GasimovDev/guitar-pedal/hardware/fab/enclosure-drill-template.pdf

## PEDAL FACE (top of the box) - drilling template, seen from OUTSIDE

Print at 100 % ('actual size', no 'fit to page'). Check the 50 mm bar with a ruler.
Tape it on the box, centre-punch every cross, drill small (3 mm) first, then open up with a step drill.

this bar must measure exactly 50 mm

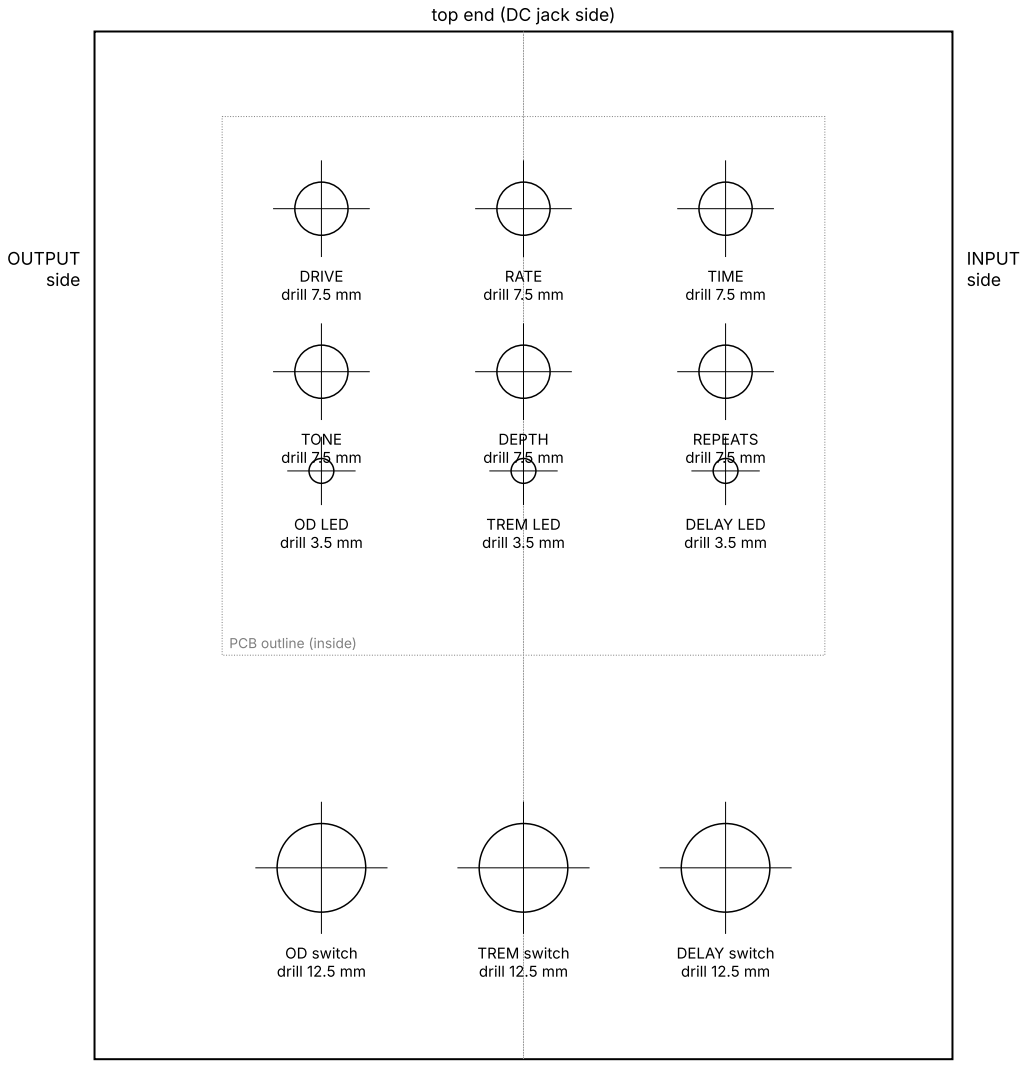
[picture p3: figure]
top end (DC jack side); OUTPUT side; INPUT side; PCB outline (inside); DRIVE drill 7.5 mm; TONE drill 7.5 mm; RATE drill 7.5 mm; DEPTH drill 7.5 mm; TIME drill 7.5 mm; REPEATS drill 7.5 mm; OD LED drill 3.5 mm; TREM LED drill 3.5 mm; DELAY LED drill 3.5 mm; OD switch drill 12.5 mm; TREM switch drill 12.5 mm; DELAY switch drill 12.5 mm

Hole centres, mm from the face's top-left corner (seen from outside):
DRIVE | x 32.0 y 25.0 (7.5)
TONE | x 32.0 y 48.0 (7.5)
RATE | x 60.5 y 25.0 (7.5)
DEPTH | x 60.5 y 48.0 (7.5)
TIME | x 89.0 y 25.0 (7.5)
REPEATS | x 89.0 y 48.0 (7.5)
OD LED | x 32.0 y 62.0 (3.5)
TREM LED | x 60.5 y 62.0 (3.5)
DELAY LED | x 89.0 y 62.0 (3.5)
OD switch | x 32.0 y 118.0 (12.5)
TREM switch x 60.5 y 118.0 (12.5) DELAY switch x 89.0 y 118.0 (12.5)

Drawn for a Hammond 1590XX (145 x 121 x 39 mm). Different box? Keep the holes' positions relative to each other (they match the PCB) and centre the group on your box.

## SIDE WALLS - seen from OUTSIDE, face edge at the top

All three holes are 24 mm down from the face. That keeps the jacks below the parts on the PCB. Solder the jack and switch wires straight into J1/J2/J3/J6 (no pin headers there), so nothing sticks down.

this bar must measure exactly 50 mm

TOP END wall (121 mm)

face (top) edge

open edge (lid)

9 V DC jack
drill 12.0 mm

The DC jack sits in the middle of the top end.

RIGHT side wall = INPUT (145 mm). Top end of the box is at the RIGHT of this drawing.

face (top) edge

open edge (lid)

INPUT jack
drill 9.5 mm

Input jack centre: 33.5 mm from the top end.

LEFT side wall = OUTPUT (145 mm). Top end of the box is at the LEFT of this drawing.

face (top) edge

open edge (lid)

OUTPUT jack
drill 9.5 mm

Output jack centre: 33.5 mm from the top end.
