GasimovDev/guitar-pedal/docs/img/pcb_bottom.png

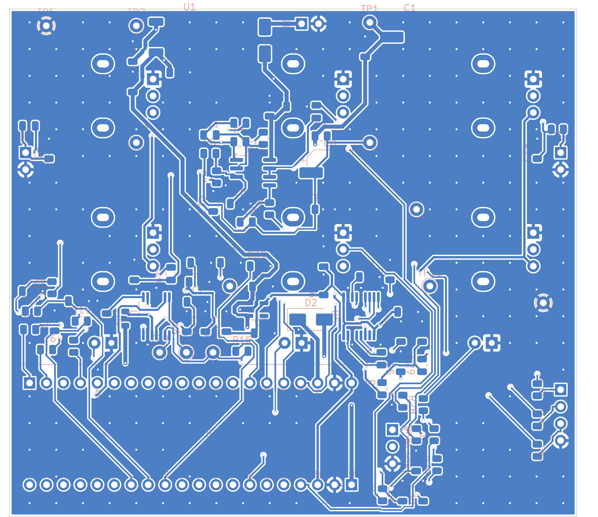
docs/img/pcb_bottom.png
