GasimovDev/guitar-pedal/docs/img/pcb_top.png

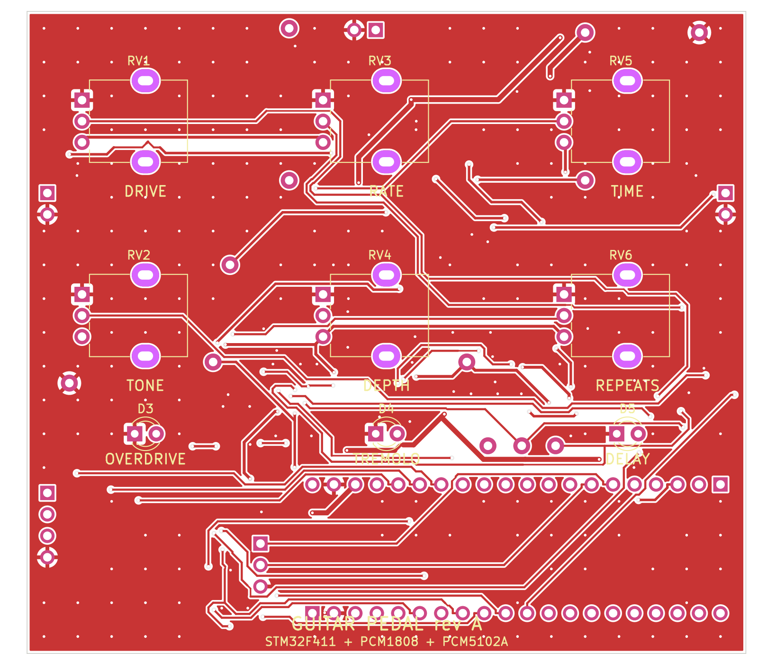
docs/img/pcb_top.png
