GasimovDev/guitar-pedal/hardware/fab/bom_jlc.csv

Comment | Designator | Footprint | LCSC Part # | Manufacturer Part | Qty
100uF 25V electrolytic | C1 | SMD electrolytic 6.3x7.7mm |  |  | 1
100nF 50V X7R/X5R | C2,C5,C9,C17,C19,C20,C25,C26,C27,C31,C33,C34,C35,C36,C37,C38,C39,C40,C41 | 0805 |  |  | 19
1uF 25V X7R/X5R | C3 | 0805 |  |  | 1
10uF 16V X7R/X5R | C4,C7,C12,C14,C16,C18,C24,C29,C30 | 0805 |  |  | 9
1uF 16V X7R/X5R | C6,C15,C23 | 0805 |  |  | 3
47uF 25V electrolytic | C8 | SMD electrolytic 6.3x5.4mm |  |  | 1
100pF 50V C0G/NP0 | C10,C11 | 0805 |  |  | 2
2.2nF 50V C0G/NP0 | C13,C28 | 0805 |  |  | 2
2.2uF 16V X7R/X5R | C21,C22 | 0805 |  |  | 2
10uF 25V X7R/X5R | C32 | 0805 |  |  | 1
SS34 | D1 | SMA (DO-214AC) |  | SS34 | 1
SS14 | D2 | SMA (DO-214AC) |  | SS14 | 1
Ferrite bead 600R@100MHz | FB1 | 0805 |  | BLM21PG601SN1D | 1
10k 1% 1/8W | R1,R2,R7,R9,R12 | 0805 |  |  | 5
1M 1% 1/8W | R3,R5 | 0805 |  |  | 2
1k 1% 1/8W | R4,R8,R14,R19,R20,R21,R22,R23,R24,R25,R26,R27 | 0805 |  |  | 12
5.1k 1% 1/8W | R6 | 0805 |  |  | 1
470 1% 1/8W | R10,R28,R29,R30 | 0805 |  |  | 4
22k 1% 1/8W | R11 | 0805 |  |  | 1
100k 1% 1/8W | R13 | 0805 |  |  | 1
33 1% 1/8W | R15,R16,R17,R18 | 0805 |  |  | 4
L78M05 | U1 | TO-252 (DPAK) |  | L78M05CDT-TR | 1
AP2112K-3.3 | U2 | SOT-23-5 |  | AP2112K-3.3TRG1 | 1
OPA1678 | U3 | SOIC-8 |  | OPA1678IDR | 1
PCM1808 | U4 | TSSOP-14 |  | PCM1808PWR | 1
PCM5102A | U5 | TSSOP-20 |  | PCM5102APWR | 1
