GasimovDev/guitar-pedal/hardware/fab/schematic.pdf

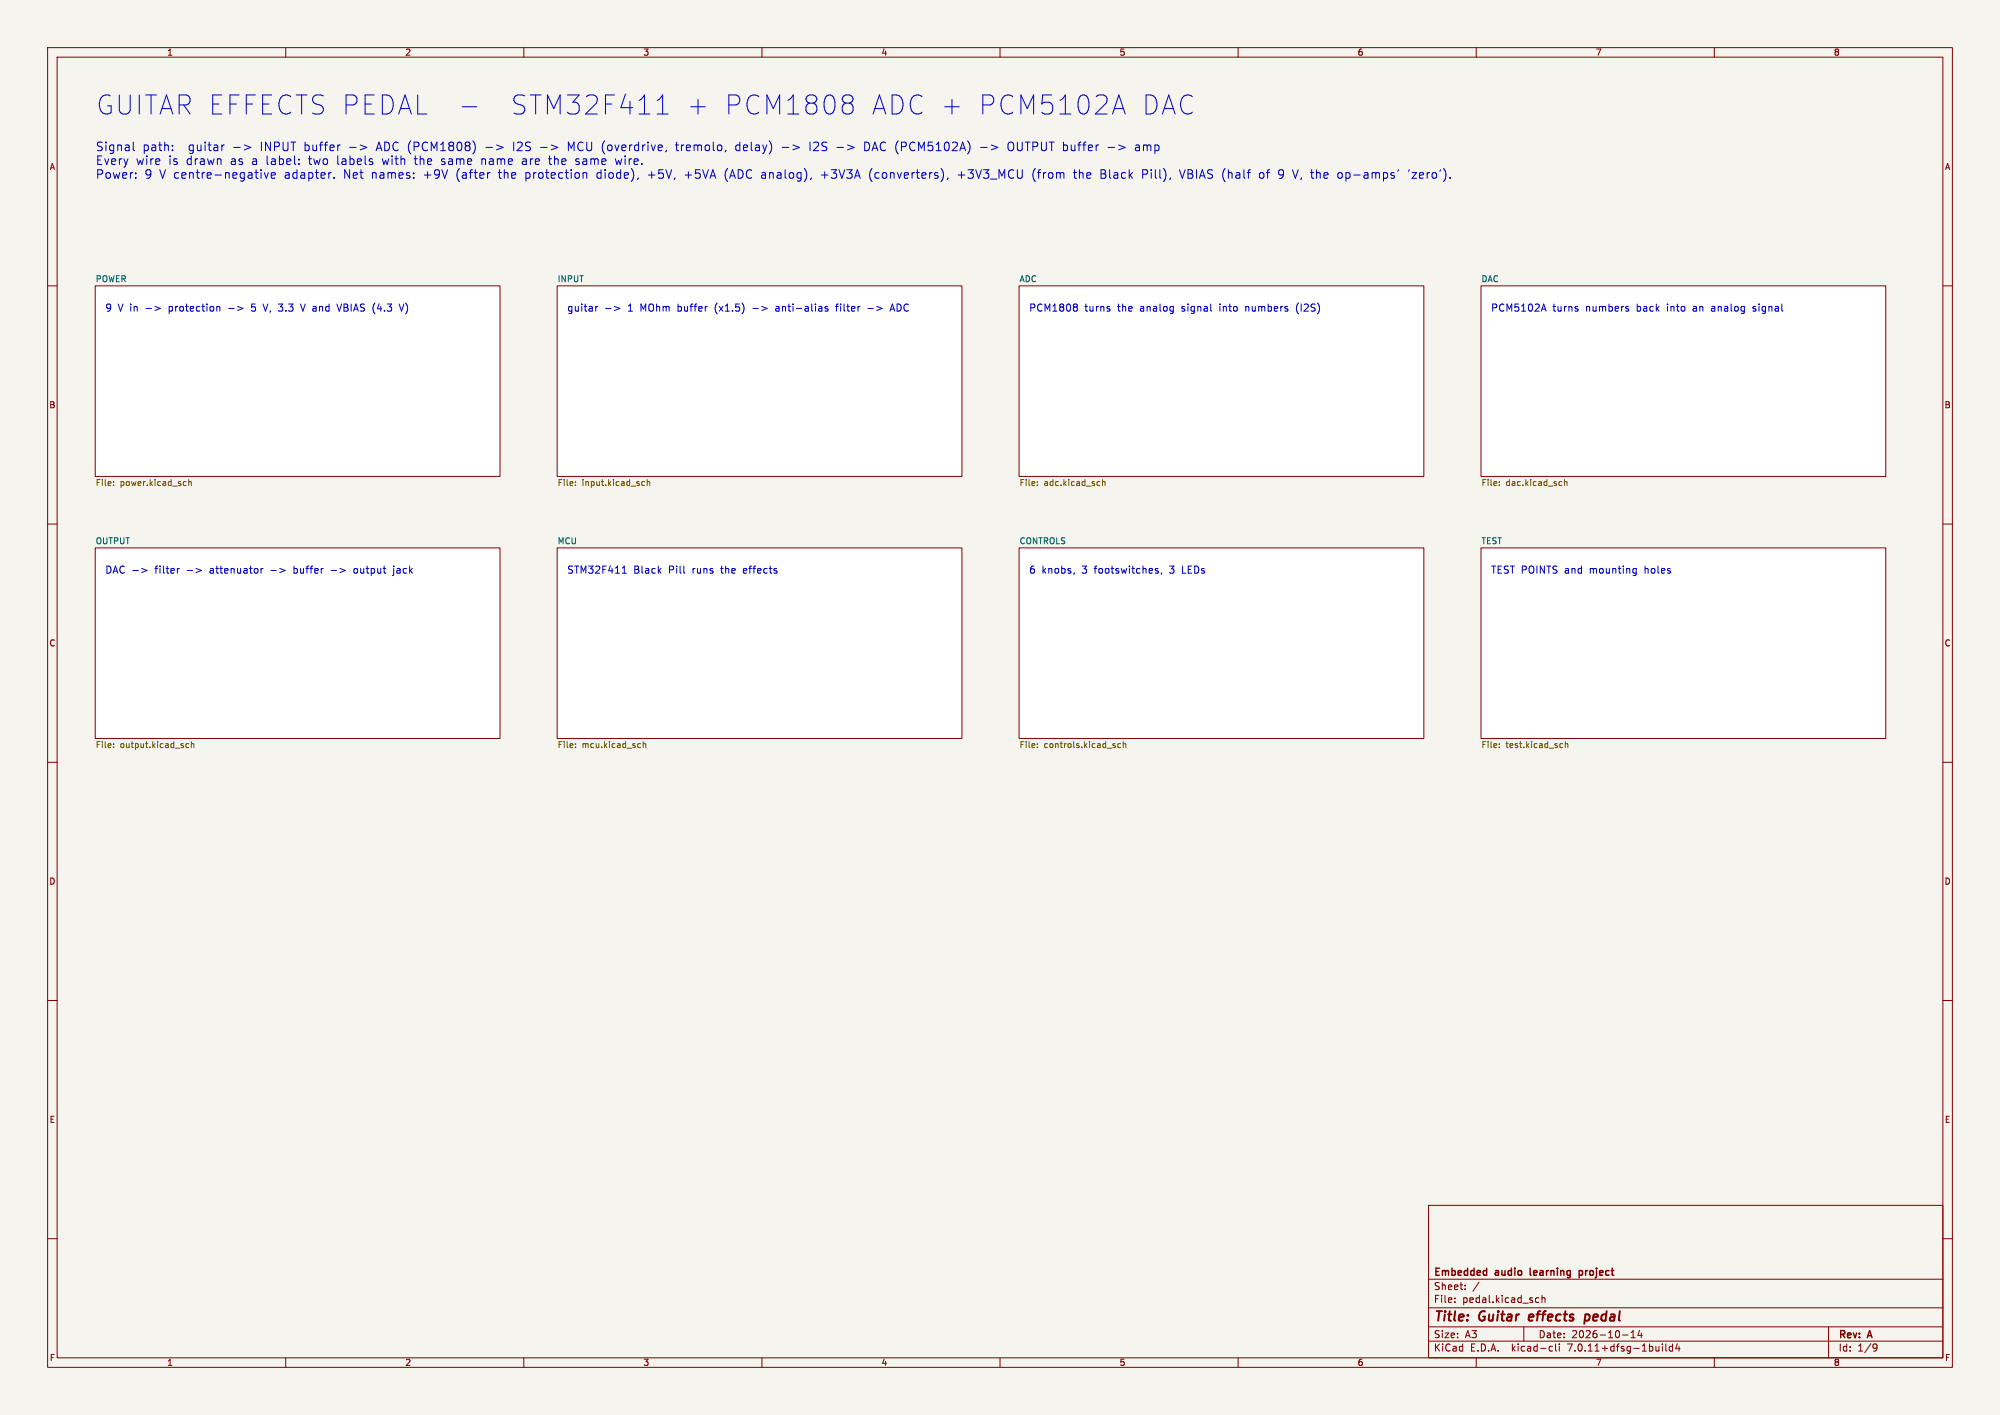
[picture p6: page 1]

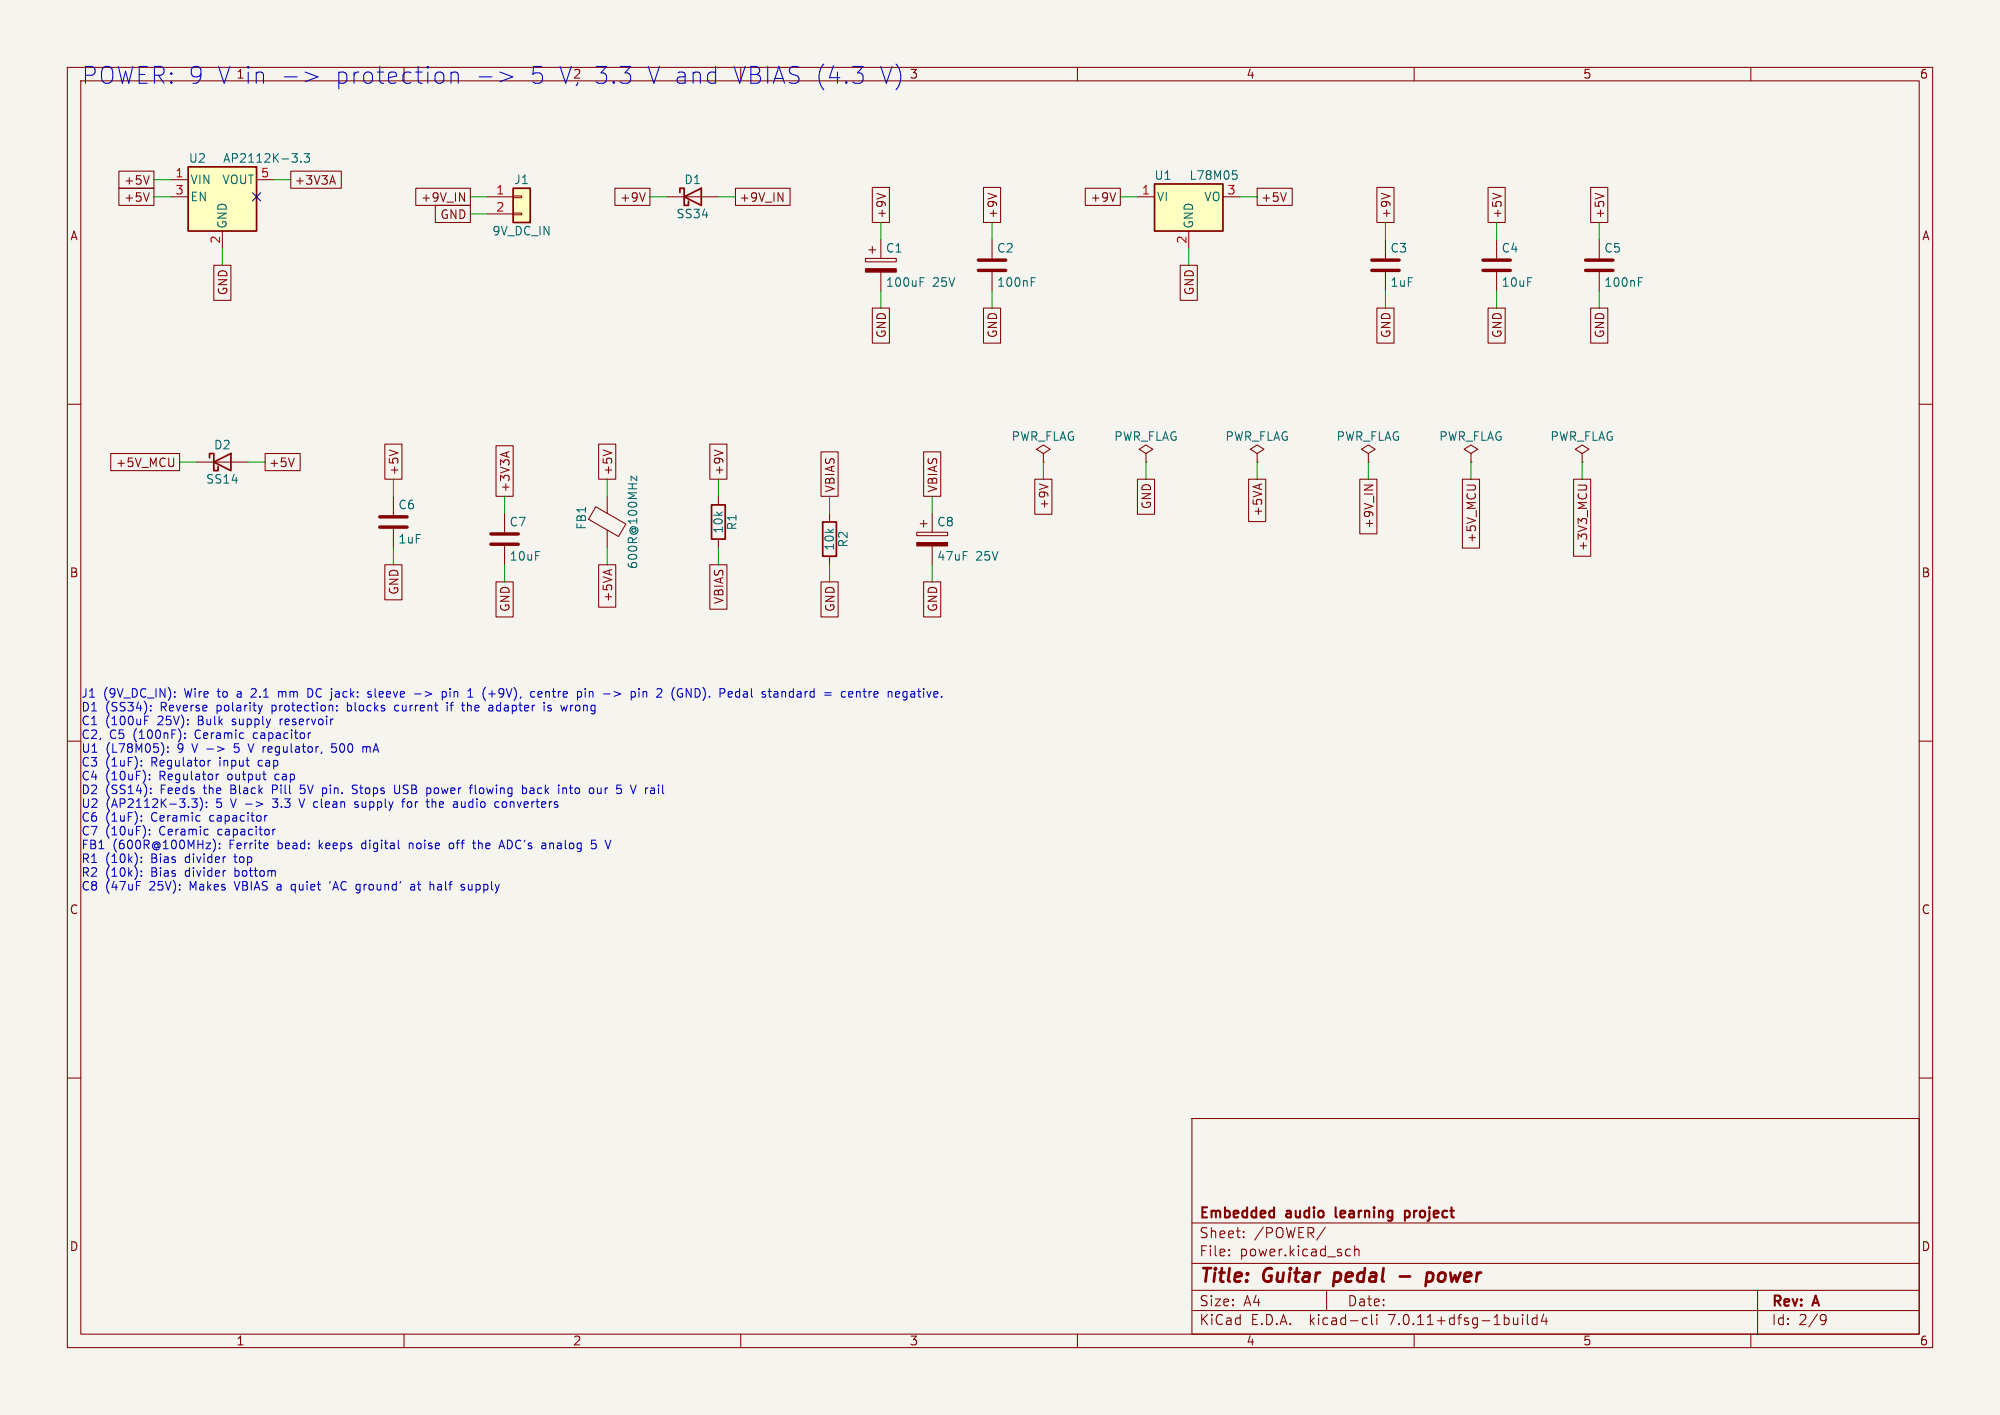
[picture p7: page 2]

C8 (47uF 25V): Makes VBIAS a quiet 'AC ground' at half supply

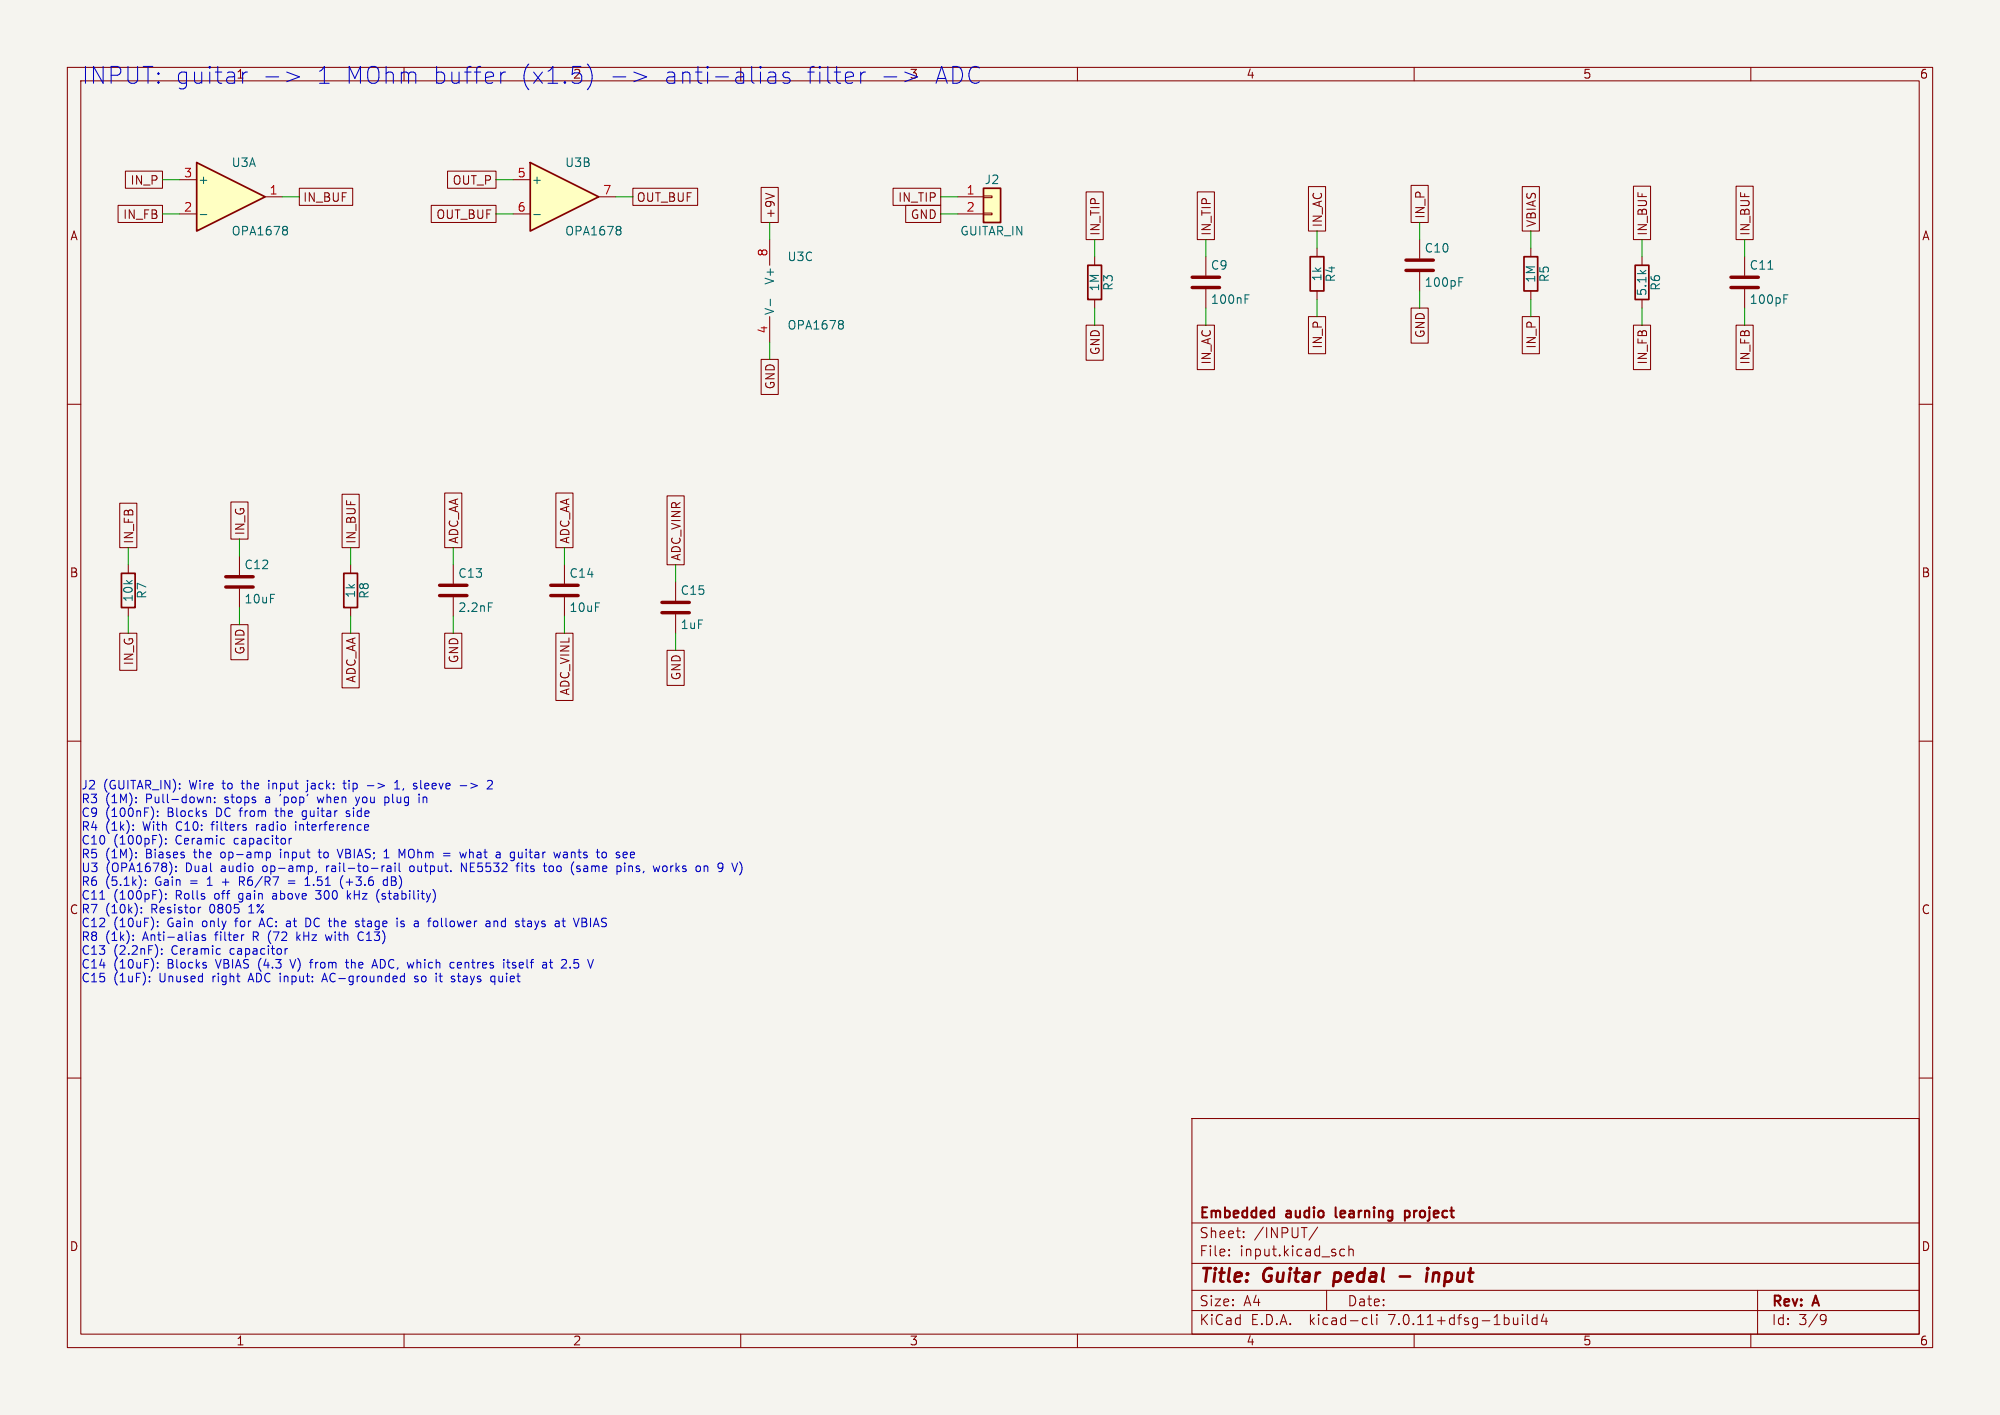
[picture p8: page 3]

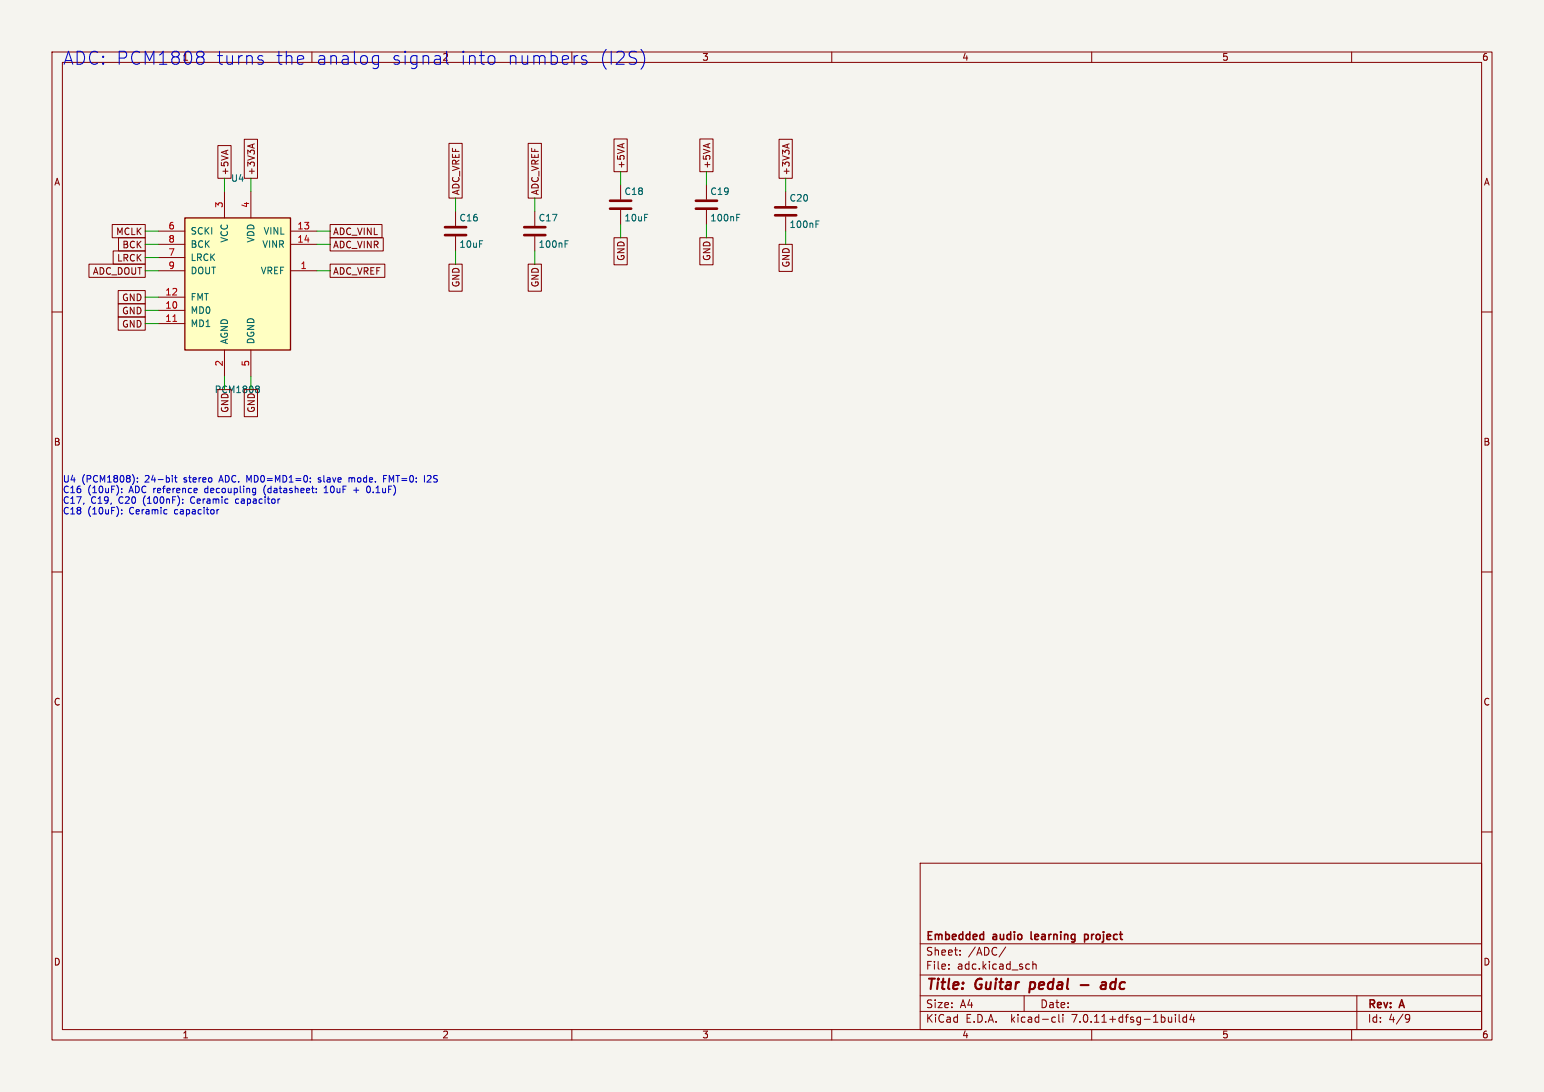
[picture p9: page 4]

Id: 4/9 Title: Guitar pedal - adc

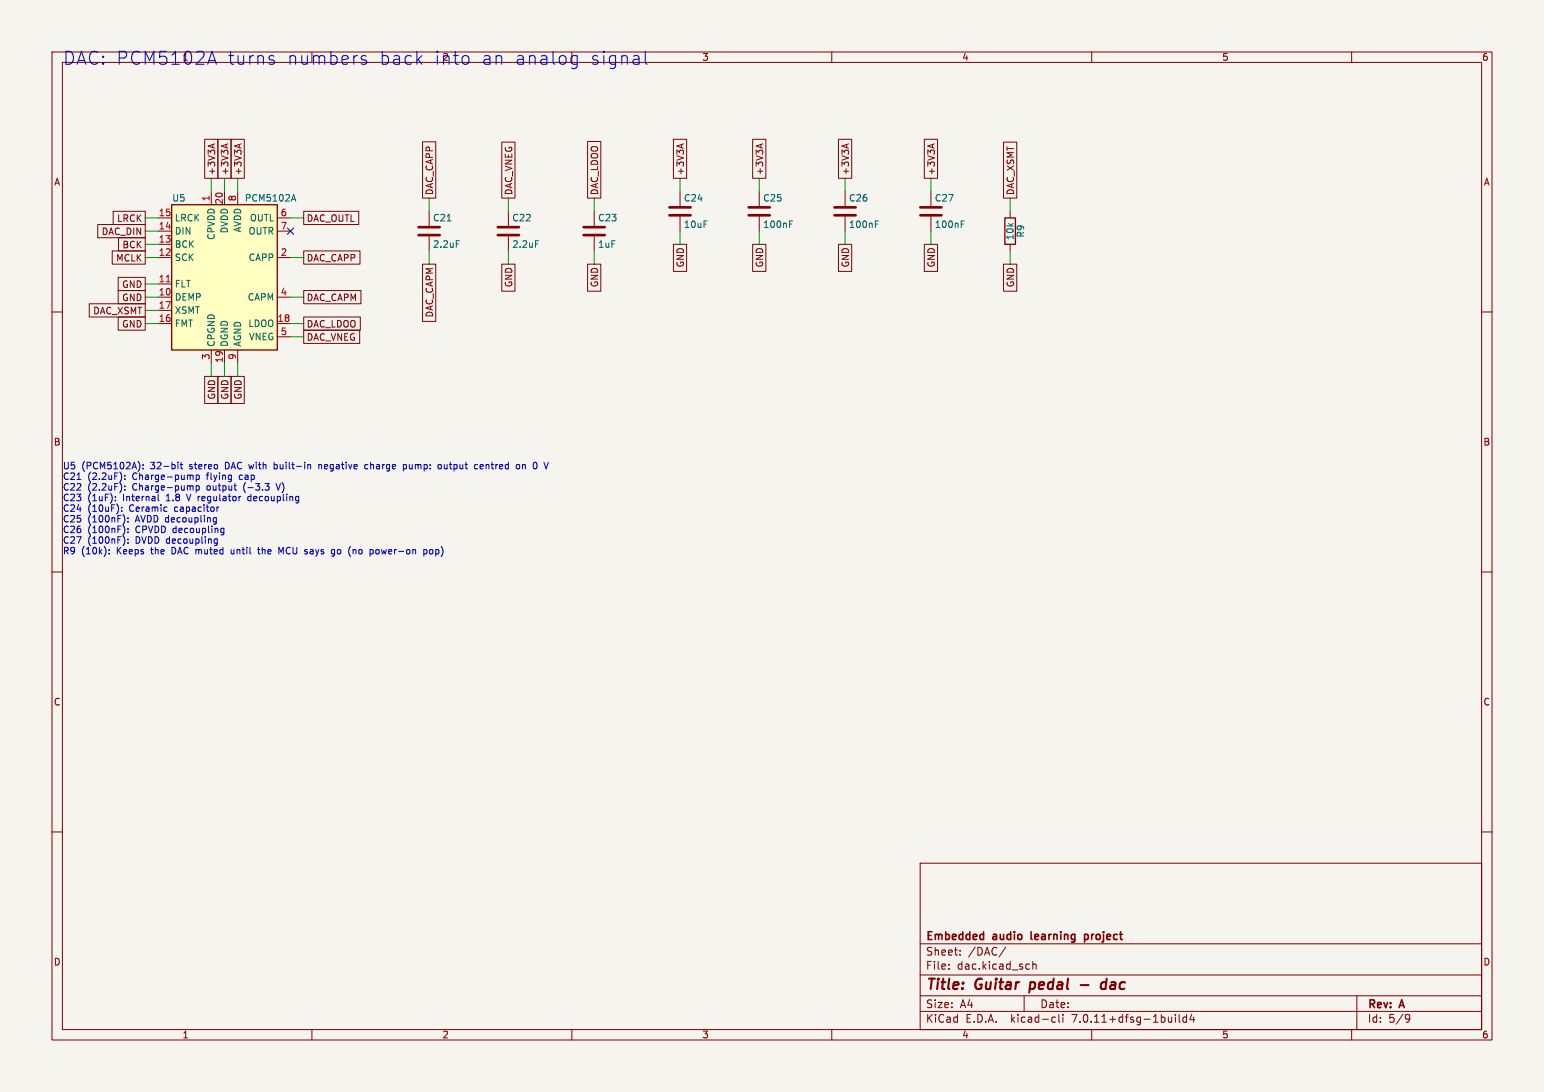
[picture p10: page 5]

LRCK GND GND MCLK

1 DEMP 10 FLT 11 SCK 12 BCK 13 DIN 14

3 CAPM 4 VNEG 5 OUTL 6 OUTR 7 AVDD

Id: 5/9 Title: Guitar pedal - dac

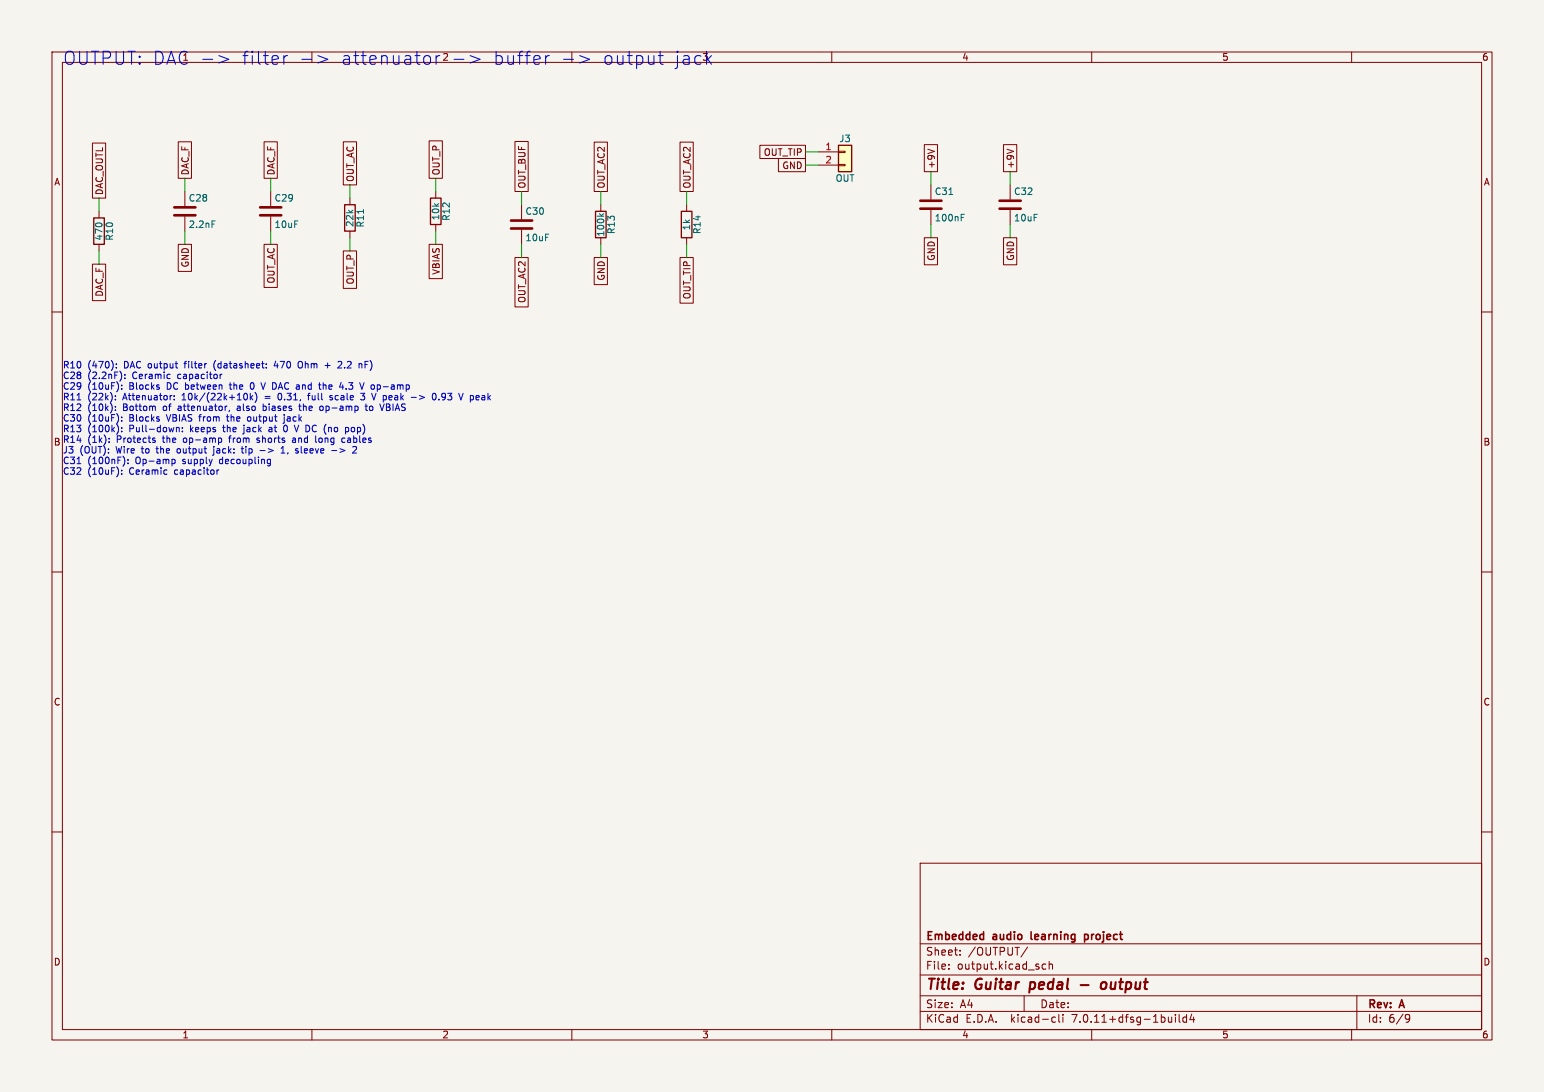
[picture p11: page 6]

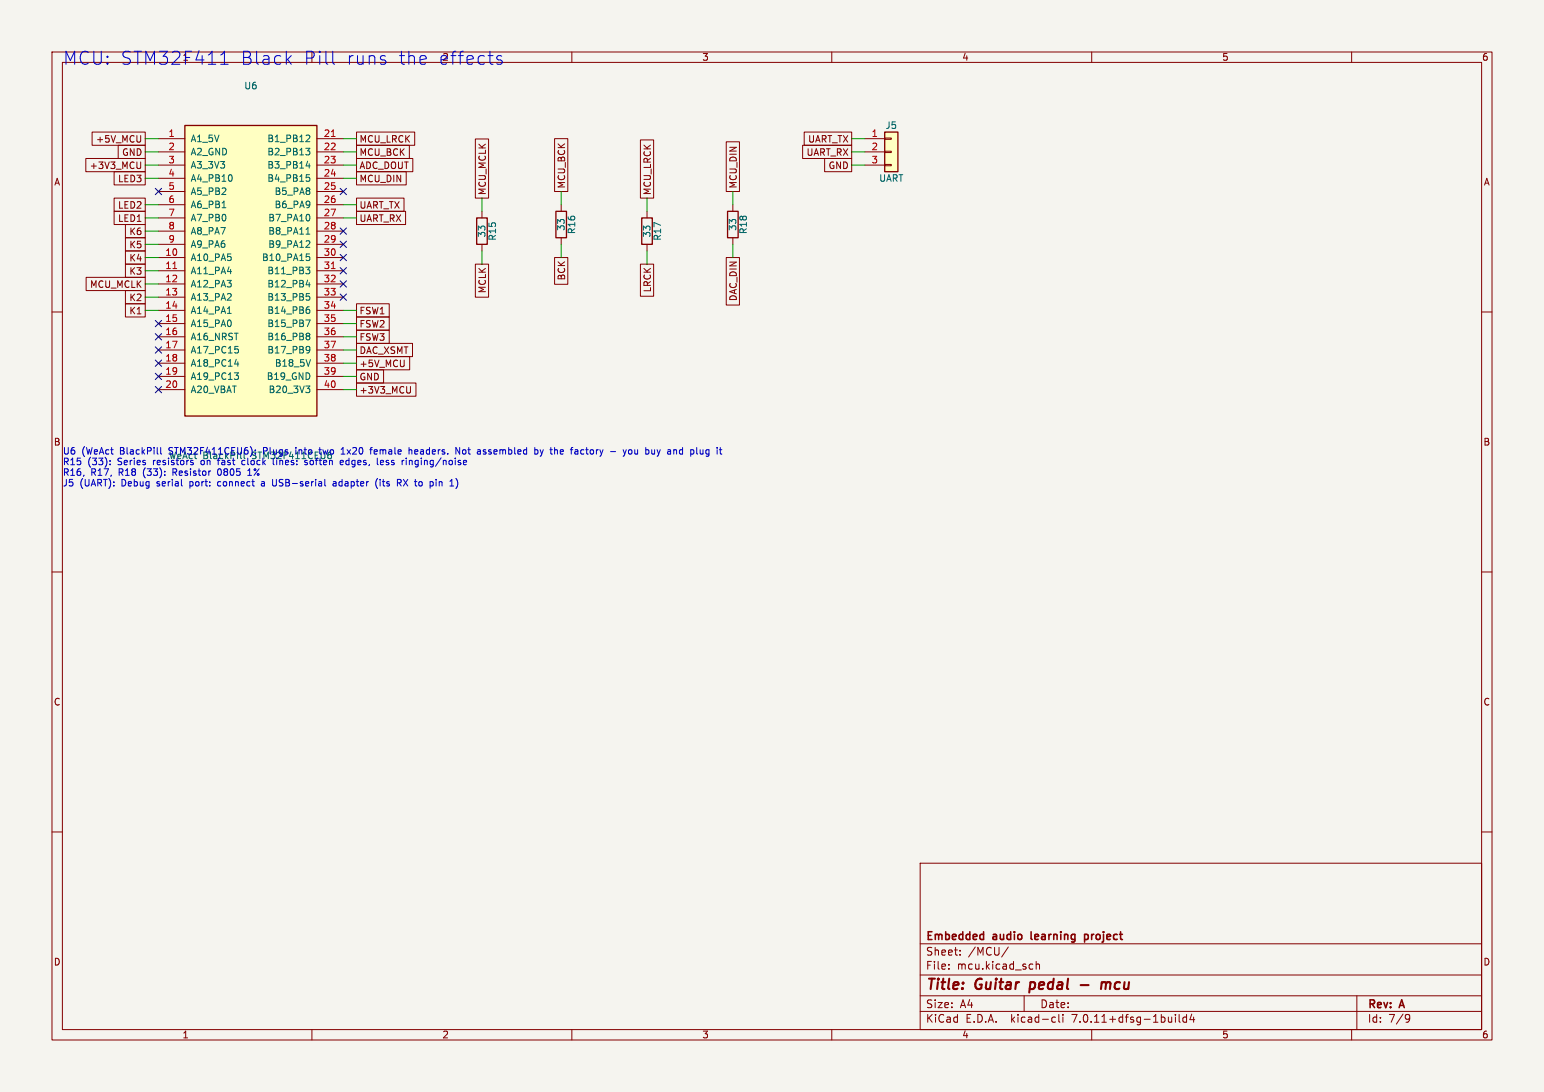
[picture p12: page 7]

MCU: STM32F411 Black Pill runs the effects

Id: 7/9 Title: Guitar pedal - mcu

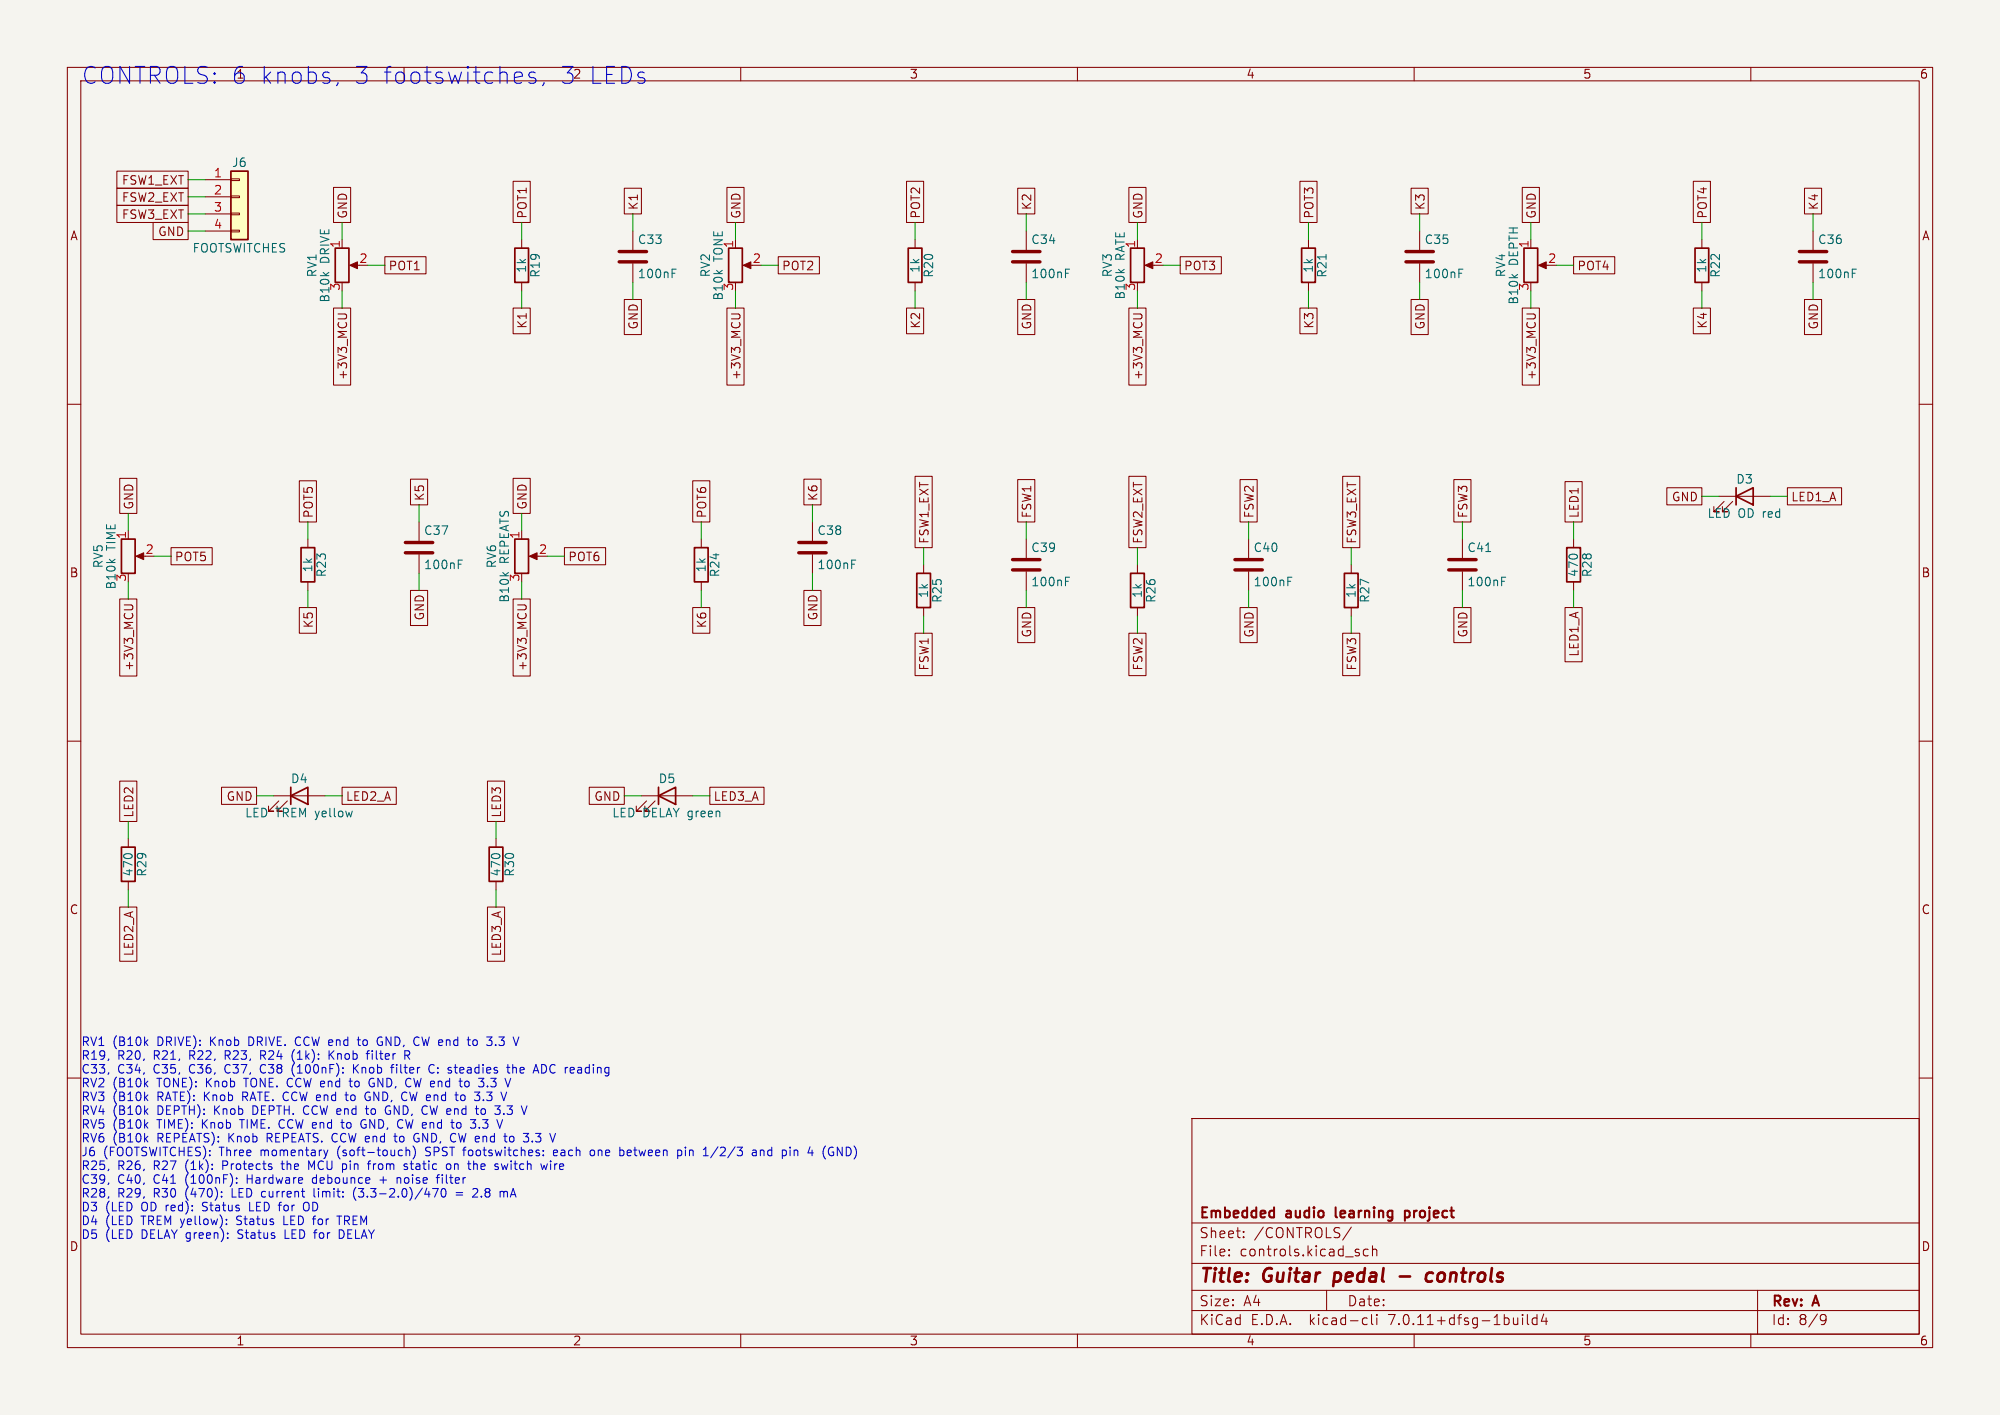
[picture p13: page 8]

RV1 (B10k DRIVE): Knob DRIVE. CCW end to GND, CW end to 3.3 V R19, R20, R21, R22, R23, R24 (1k): Knob filter R

Id: 8/9 Title: Guitar pedal - controls

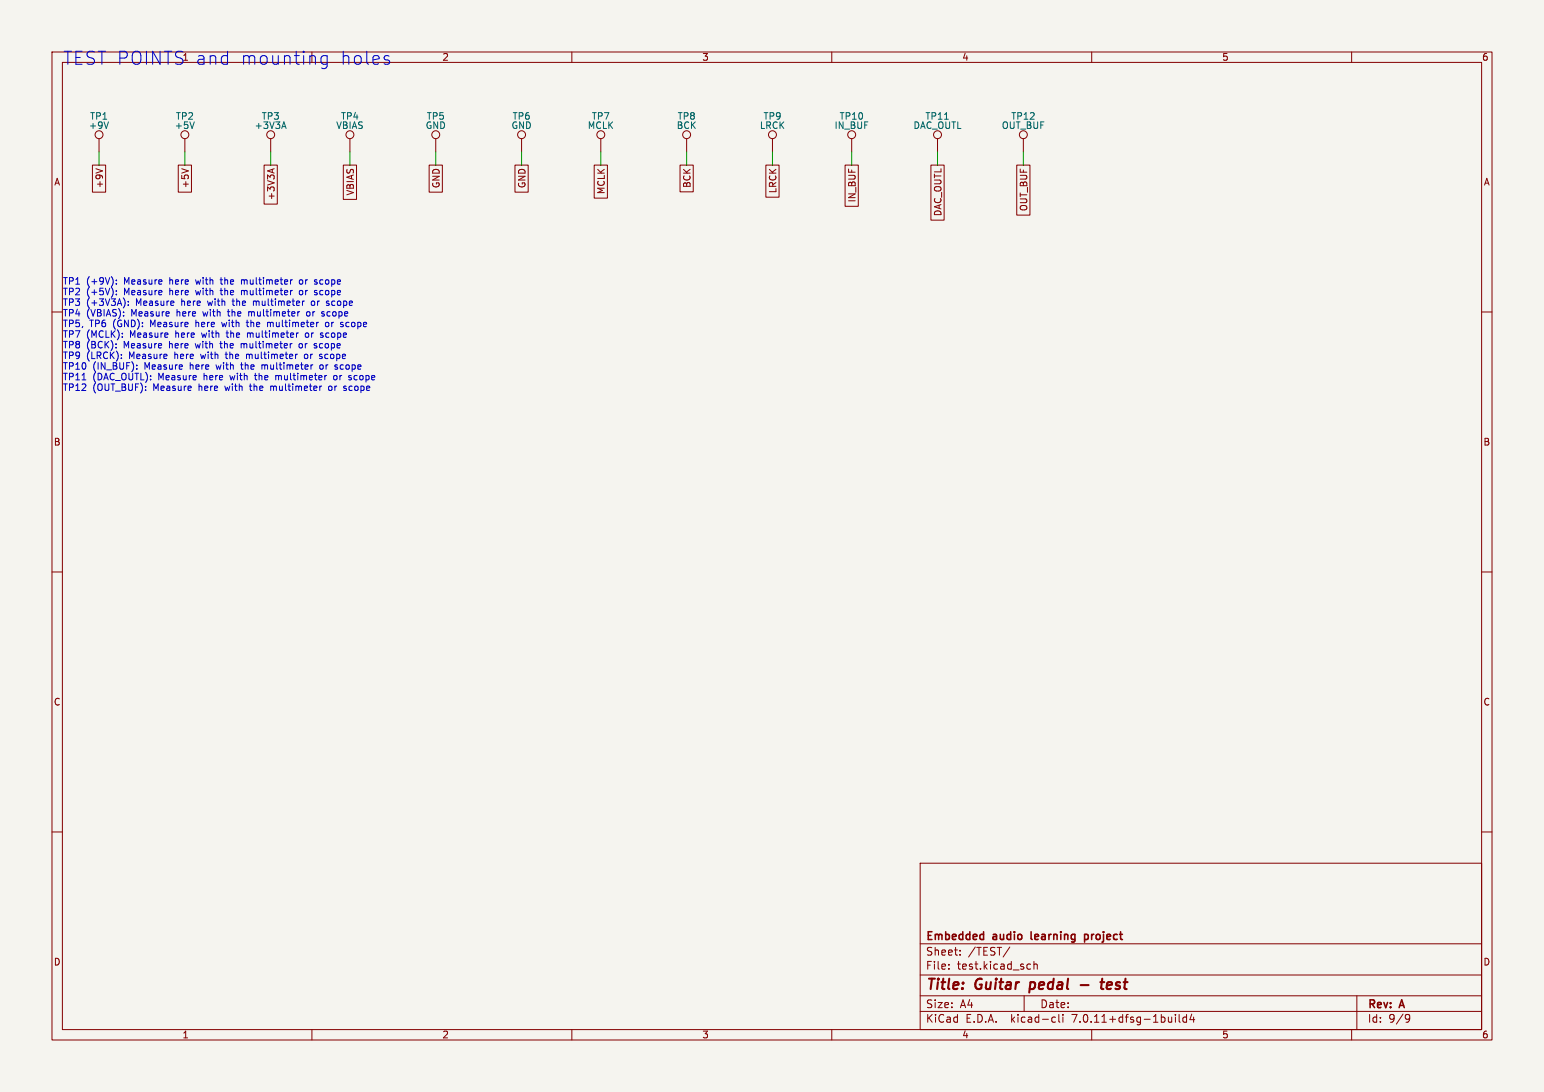
[picture p14: page 9]
