GasimovDev/guitar-pedal/hardware/pedal.kicad_pcb

## KiCad design hardware/pedal.kicad_pcb (2026-10-16)

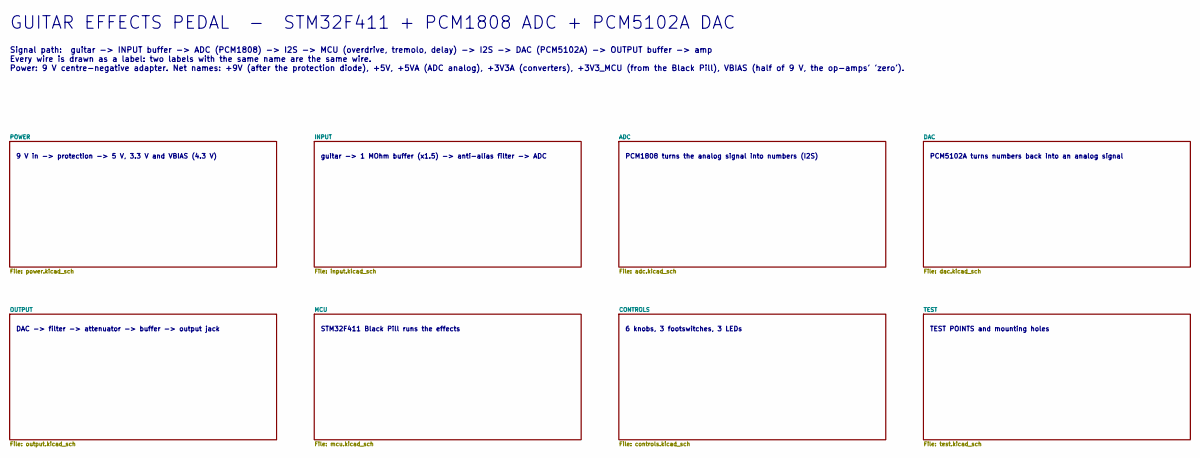
[picture p15: schematic pedal.kicad_sch, Guitar effects pedal]

Notes on the sheet:
GUITAR EFFECTS PEDAL - STM32F411 + PCM1808 ADC + PCM5102A DAC
Signal path: guitar -> INPUT buffer -> ADC (PCM1808) -> I2S -> MCU (overdrive, tremolo, delay) -> I2S -> DAC (PCM5102A) -> OUTPUT buffer -> amp Every wire is drawn as a label: two labels with the same name are the same wire. Power: 9 V centre-negative adapter. Net names: +9V (after the protection d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
9 V in -> protection -> 5 V, 3.3 V and VBIAS (4.3 V)
guitar -> 1 MOhm buffer (x1.5) -> anti-alias filter -> ADC
PCM1808 turns the analog signal into numbers (I2S)
PCM5102A turns numbers back into an analog signal
DAC -> filter -> attenuator -> buffer -> output jack
STM32F411 Black Pill runs the effects
6 knobs, 3 footswitches, 3 LEDs
TEST POINTS and mounting holes

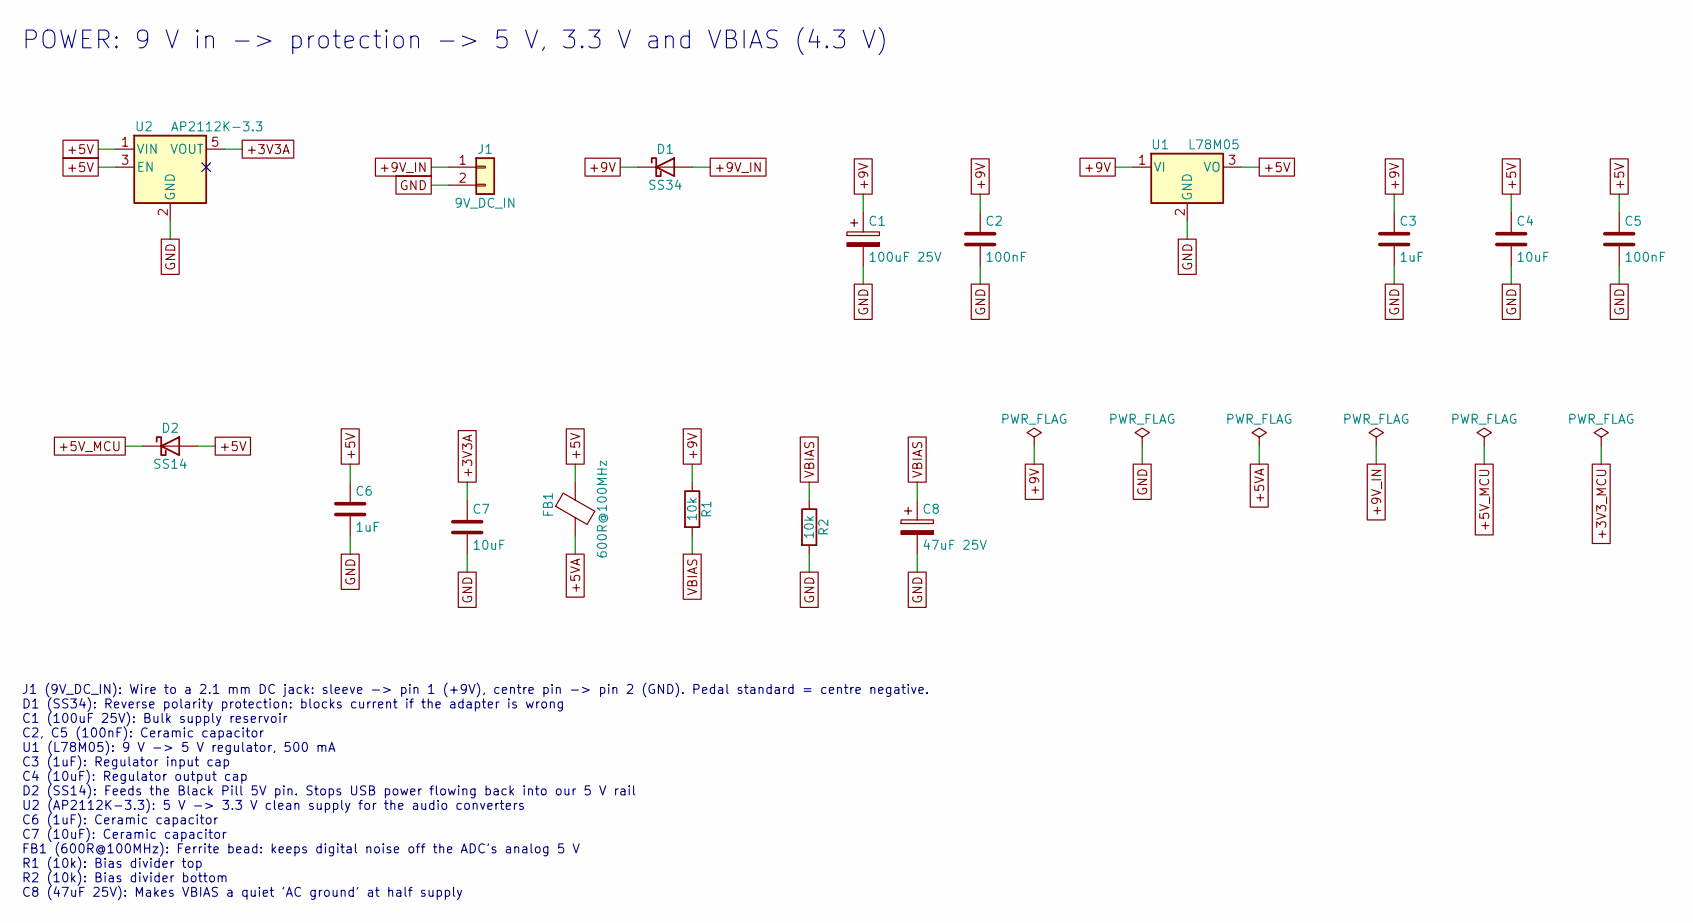
[picture p16: schematic power.kicad_sch, Guitar pedal - power]

Parts:
C1: 100uF 25V; CP_Elec_6.3x7.7; MPN 100uF 25V SMD electrolytic 6.3x7.7
C2, C5: 100nF; C_0805_2012Metric; MPN 0805 100nF X7R
C3, C6: 1uF; C_0805_2012Metric; MPN 0805 1uF X7R
C4, C7: 10uF; C_0805_2012Metric; MPN 0805 10uF X7R
C8: 47uF 25V; CP_Elec_6.3x5.4; MPN 47uF 25V SMD electrolytic 6.3x5.4
D1: SS34; D_SMA; MPN SS34
D2: SS14; D_SMA; MPN SS14
FB1: 600R@100MHz; L_0805_2012Metric; MPN BLM21PG601SN1D
J1: 9V_DC_IN; PinHeader_1x02_P2.54mm_Vertical; MPN 2.54mm header 1x2
R1, R2: 10k; R_0805_2012Metric; MPN 0805 10k 1%
U1: L78M05; TO-252-2; MPN L78M05CDT-TR
U2: AP2112K-3.3; SOT-23-5; MPN AP2112K-3.3TRG1

Connections:
+3V3A: C7.1, U2.5 (VOUT); also elsewhere on the board
+5V: C4.1, C5.1, C6.1, D2.2 (A), FB1.1, U1.3 (VO), U2.1 (VIN), U2.3 (EN); also elsewhere on the board
+5VA: FB1.2; also elsewhere on the board
+5V_MCU: D2.1 (K); also elsewhere on the board
+9V: C1.1, C2.1, C3.1, D1.1 (K), R1.1, U1.1 (VI); also elsewhere on the board
+9V_IN: D1.2 (A), J1.1
GND: C1.2, C2.2, C3.2, C4.2, C5.2, C6.2, C7.2, C8.2, J1.2, R2.2, U1.2 (GND), U2.2 (GND); also elsewhere on the board
VBIAS: C8.1, R1.2, R2.1; also elsewhere on the board

Notes on the sheet:
POWER: 9 V in -> protection -> 5 V, 3.3 V and VBIAS (4.3 V)
J1 (9V_DC_IN): Wire to a 2.1 mm DC jack: sleeve -> pin 1 (+9V), centre pin -> pin 2 (GND). Pedal standard = centre negative. D1 (SS34): Reverse polarity protection: blocks current if the adapter is wrong C1 (100uF 25V): Bulk supply reservoir C2, C5 (100nF): Ceramic capacitor U1 (L78M05): 9 V -> 5 V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

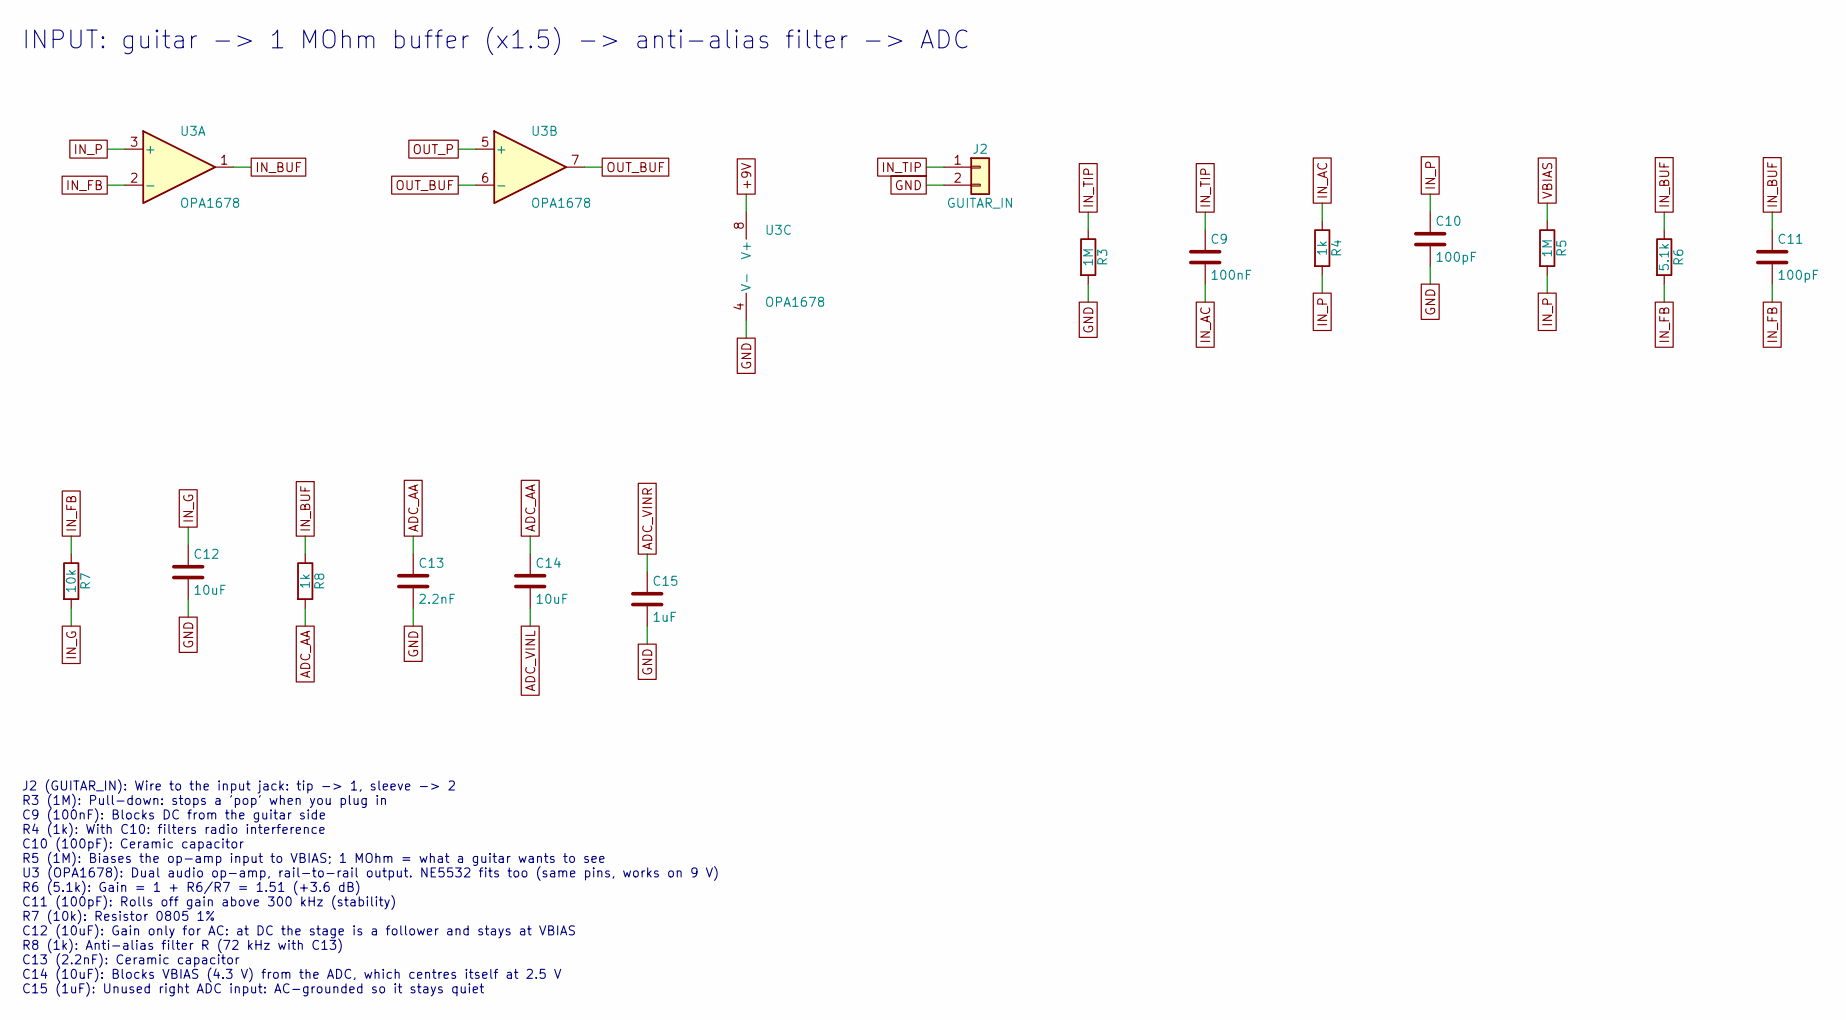
[picture p17: schematic input.kicad_sch, Guitar pedal - input]

Parts:
C9: 100nF; C_0805_2012Metric; MPN 0805 100nF X7R
C10, C11: 100pF; C_0805_2012Metric; MPN 0805 100pF C0G
C12, C14: 10uF; C_0805_2012Metric; MPN 0805 10uF X7R
C13: 2.2nF; C_0805_2012Metric; MPN 0805 2.2nF C0G
C15: 1uF; C_0805_2012Metric; MPN 0805 1uF X7R
J2: GUITAR_IN; PinHeader_1x02_P2.54mm_Vertical; MPN 2.54mm header 1x2
R3, R5: 1M; R_0805_2012Metric; MPN 0805 1M 1%
R4, R8: 1k; R_0805_2012Metric; MPN 0805 1k 1%
R6: 5.1k; R_0805_2012Metric; MPN 0805 5.1k 1%
R7: 10k; R_0805_2012Metric; MPN 0805 10k 1%
U3: OPA1678; SOIC-8_3.9x4.9mm_P1.27mm; MPN OPA1678IDR

Connections:
+9V: U3.8 (V+); also elsewhere on the board
ADC_AA: C13.1, C14.1, R8.2
ADC_VINL: C14.2; also elsewhere on the board
ADC_VINR: C15.1; also elsewhere on the board
GND: C10.2, C12.2, C13.2, C15.2, J2.2, R3.2, U3.4 (V-); also elsewhere on the board
IN_AC: C9.2, R4.1
IN_BUF: C11.1, R6.1, R8.1, U3.1; also elsewhere on the board
IN_FB: C11.2, R6.2, R7.1, U3.2 (-)
IN_G: C12.1, R7.2
IN_P: C10.1, R4.2, R5.2, U3.3 (+)
IN_TIP: C9.1, J2.1, R3.1
OUT_BUF: U3.6 (-), U3.7; also elsewhere on the board
OUT_P: U3.5 (+); also elsewhere on the board
VBIAS: R5.1; also elsewhere on the board

Notes on the sheet:
INPUT: guitar -> 1 MOhm buffer (x1.5) -> anti-alias filter -> ADC
J2 (GUITAR_IN): Wire to the input jack: tip -> 1, sleeve -> 2 R3 (1M): Pull-down: stops a 'pop' when you plug in C9 (100nF): Blocks DC from the guitar side R4 (1k): With C10: filters radio interference C10 (100pF): Ceramic capacitor R5 (1M): Biases the op-amp input to VBIAS; 1 MOhm = what a guitar 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

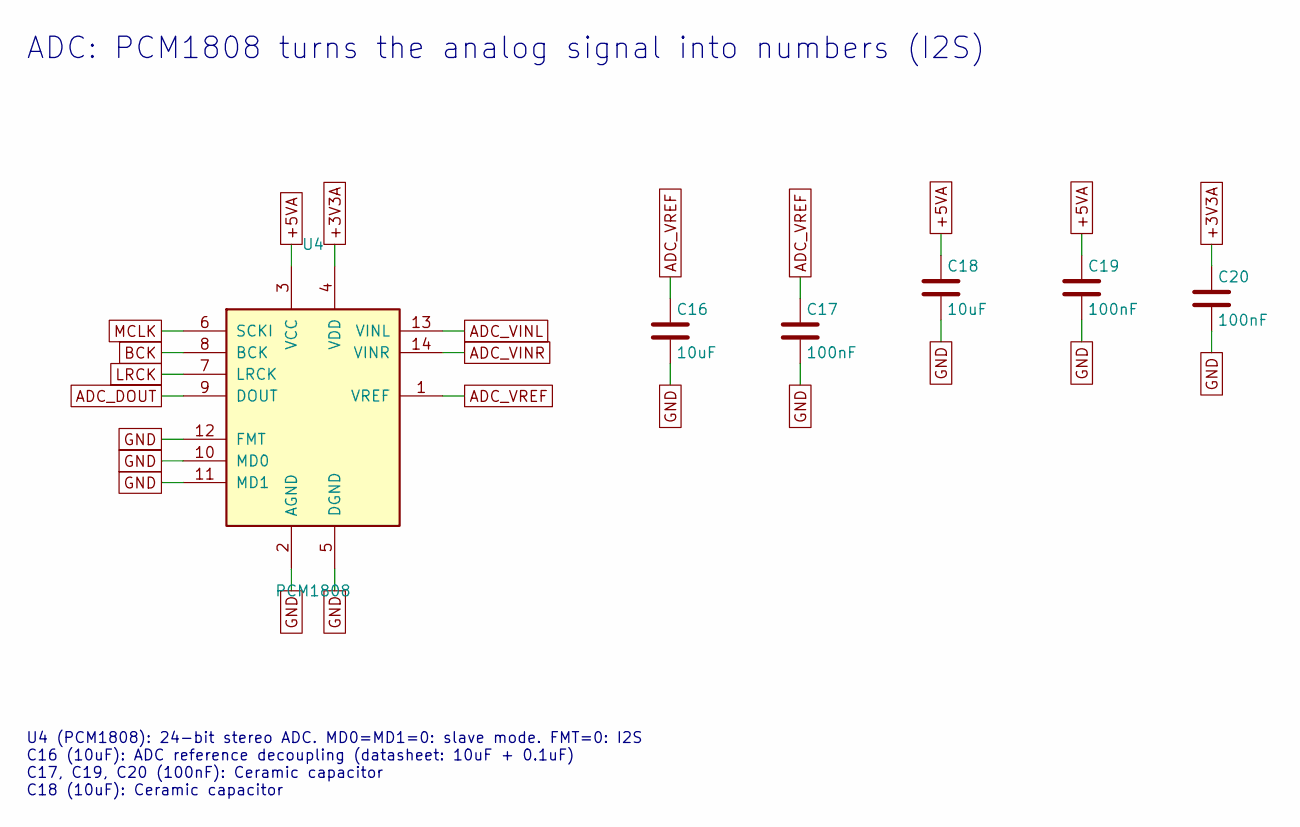
[picture p18: schematic adc.kicad_sch, Guitar pedal - adc]

Parts:
C16, C18: 10uF; C_0805_2012Metric; MPN 0805 10uF X7R
C17, C19, C20: 100nF; C_0805_2012Metric; MPN 0805 100nF X7R
U4: PCM1808; TSSOP-14_4.4x5mm_P0.65mm; MPN PCM1808PWR

Connections:
+3V3A: C20.1, U4.4 (VDD); also elsewhere on the board
+5VA: C18.1, C19.1, U4.3 (VCC); also elsewhere on the board
ADC_DOUT: U4.9 (DOUT); also elsewhere on the board
ADC_VINL: U4.13 (VINL); also elsewhere on the board
ADC_VINR: U4.14 (VINR); also elsewhere on the board
ADC_VREF: C16.1, C17.1, U4.1 (VREF)
BCK: U4.8 (BCK); also elsewhere on the board
GND: C16.2, C17.2, C18.2, C19.2, C20.2, U4.2 (AGND), U4.5 (DGND), U4.10 (MD0), U4.11 (MD1), U4.12 (FMT); also elsewhere on the board
LRCK: U4.7 (LRCK); also elsewhere on the board
MCLK: U4.6 (SCKI); also elsewhere on the board

Notes on the sheet:
ADC: PCM1808 turns the analog signal into numbers (I2S)
U4 (PCM1808): 24-bit stereo ADC. MD0=MD1=0: slave mode. FMT=0: I2S C16 (10uF): ADC reference decoupling (datasheet: 10uF + 0.1uF) C17, C19, C20 (100nF): Ceramic capacitor C18 (10uF): Ceramic capacitor

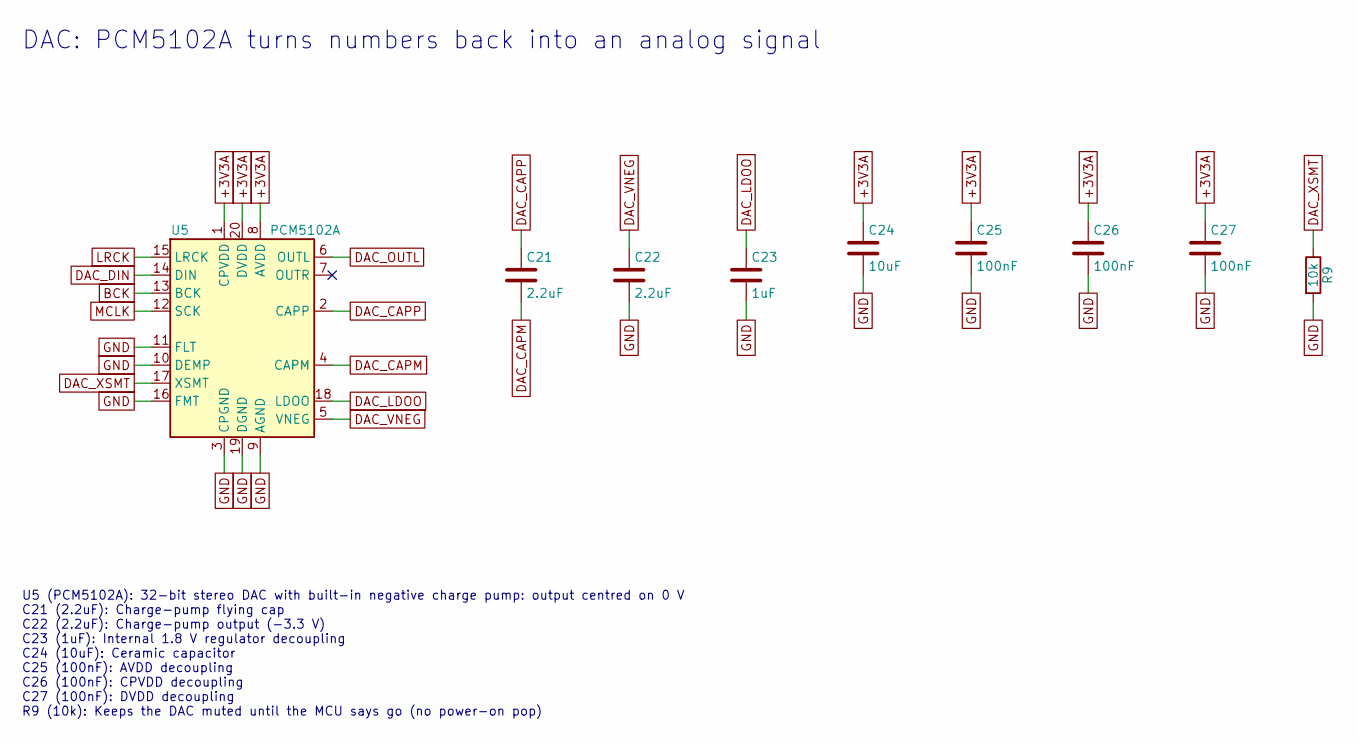
[picture p19: schematic dac.kicad_sch, Guitar pedal - dac]

Parts:
C21, C22: 2.2uF; C_0805_2012Metric; MPN 0805 2.2uF X7R
C23: 1uF; C_0805_2012Metric; MPN 0805 1uF X7R
C24: 10uF; C_0805_2012Metric; MPN 0805 10uF X7R
C25, C26, C27: 100nF; C_0805_2012Metric; MPN 0805 100nF X7R
R9: 10k; R_0805_2012Metric; MPN 0805 10k 1%
U5: PCM5102A; TSSOP-20_4.4x6.5mm_P0.65mm; MPN PCM5102APWR

Connections:
+3V3A: C24.1, C25.1, C26.1, C27.1, U5.1 (CPVDD), U5.8 (AVDD), U5.20 (DVDD); also elsewhere on the board
BCK: U5.13 (BCK); also elsewhere on the board
DAC_CAPM: C21.2, U5.4 (CAPM)
DAC_CAPP: C21.1, U5.2 (CAPP)
DAC_DIN: U5.14 (DIN); also elsewhere on the board
DAC_LDOO: C23.1, U5.18 (LDOO)
DAC_OUTL: U5.6 (OUTL); also elsewhere on the board
DAC_VNEG: C22.1, U5.5 (VNEG)
DAC_XSMT: R9.1, U5.17 (XSMT); also elsewhere on the board
GND: C22.2, C23.2, C24.2, C25.2, C26.2, C27.2, R9.2, U5.3 (CPGND), U5.9 (AGND), U5.10 (DEMP), U5.11 (FLT), U5.16 (FMT), U5.19 (DGND); also elsewhere on the board
LRCK: U5.15 (LRCK); also elsewhere on the board
MCLK: U5.12 (SCK); also elsewhere on the board

Notes on the sheet:
DAC: PCM5102A turns numbers back into an analog signal
U5 (PCM5102A): 32-bit stereo DAC with built-in negative charge pump: output centred on 0 V C21 (2.2uF): Charge-pump flying cap C22 (2.2uF): Charge-pump output (-3.3 V) C23 (1uF): Internal 1.8 V regulator decoupling C24 (10uF): Ceramic capacitor C25 (100nF): AVDD decoupling C26 (100nF): CPVDD decoup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

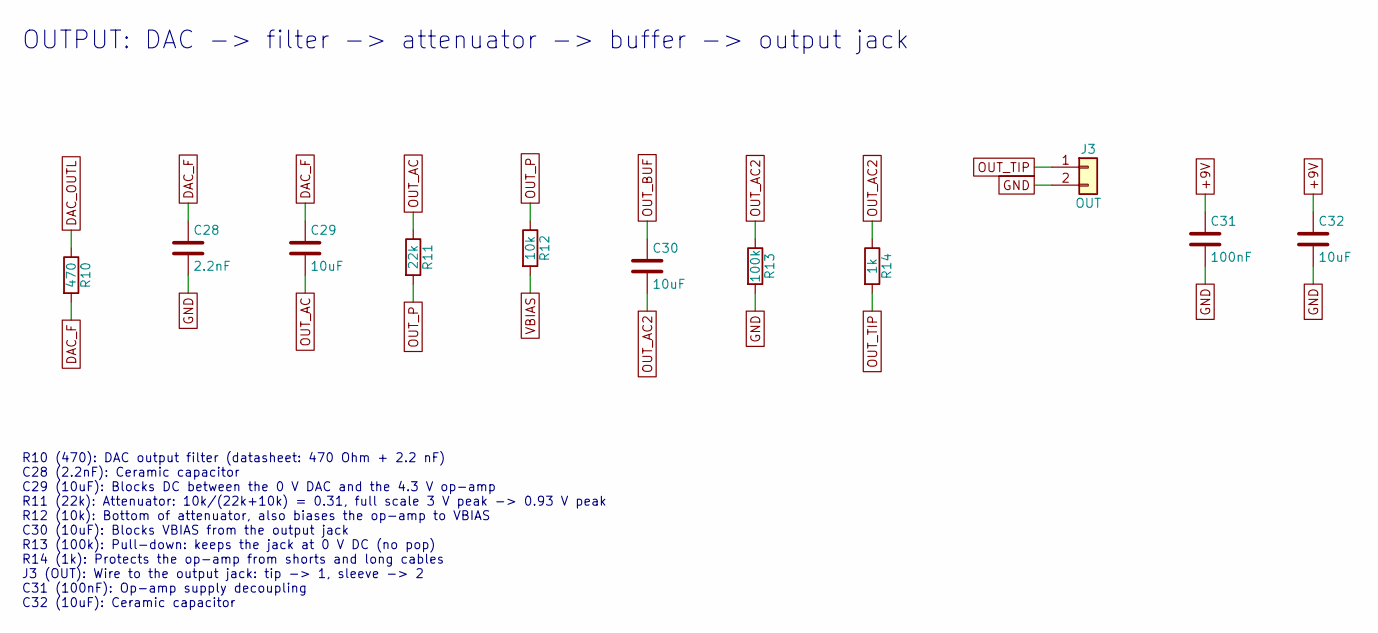
[picture p20: schematic output.kicad_sch, Guitar pedal - output]

Parts:
C28: 2.2nF; C_0805_2012Metric; MPN 0805 2.2nF C0G
C29, C30, C32: 10uF; C_0805_2012Metric; MPN 0805 10uF X7R
C31: 100nF; C_0805_2012Metric; MPN 0805 100nF X7R
J3: OUT; PinHeader_1x02_P2.54mm_Vertical; MPN 2.54mm header 1x2
R10: 470; R_0805_2012Metric; MPN 0805 470 1%
R11: 22k; R_0805_2012Metric; MPN 0805 22k 1%
R12: 10k; R_0805_2012Metric; MPN 0805 10k 1%
R13: 100k; R_0805_2012Metric; MPN 0805 100k 1%
R14: 1k; R_0805_2012Metric; MPN 0805 1k 1%

Connections:
+9V: C31.1, C32.1; also elsewhere on the board
DAC_F: C28.1, C29.1, R10.2
DAC_OUTL: R10.1; also elsewhere on the board
GND: C28.2, C31.2, C32.2, J3.2, R13.2; also elsewhere on the board
OUT_AC: C29.2, R11.1
OUT_AC2: C30.2, R13.1, R14.1
OUT_BUF: C30.1; also elsewhere on the board
OUT_P: R11.2, R12.1; also elsewhere on the board
OUT_TIP: J3.1, R14.2
VBIAS: R12.2; also elsewhere on the board

Notes on the sheet:
OUTPUT: DAC -> filter -> attenuator -> buffer -> output jack
R10 (470): DAC output filter (datasheet: 470 Ohm + 2.2 nF) C28 (2.2nF): Ceramic capacitor C29 (10uF): Blocks DC between the 0 V DAC and the 4.3 V op-amp R11 (22k): Attenuator: 10k/(22k+10k) = 0.31, full scale 3 V peak -> 0.93 V peak R12 (10k): Bottom of attenuator, also biases the op-amp to VBIAS C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

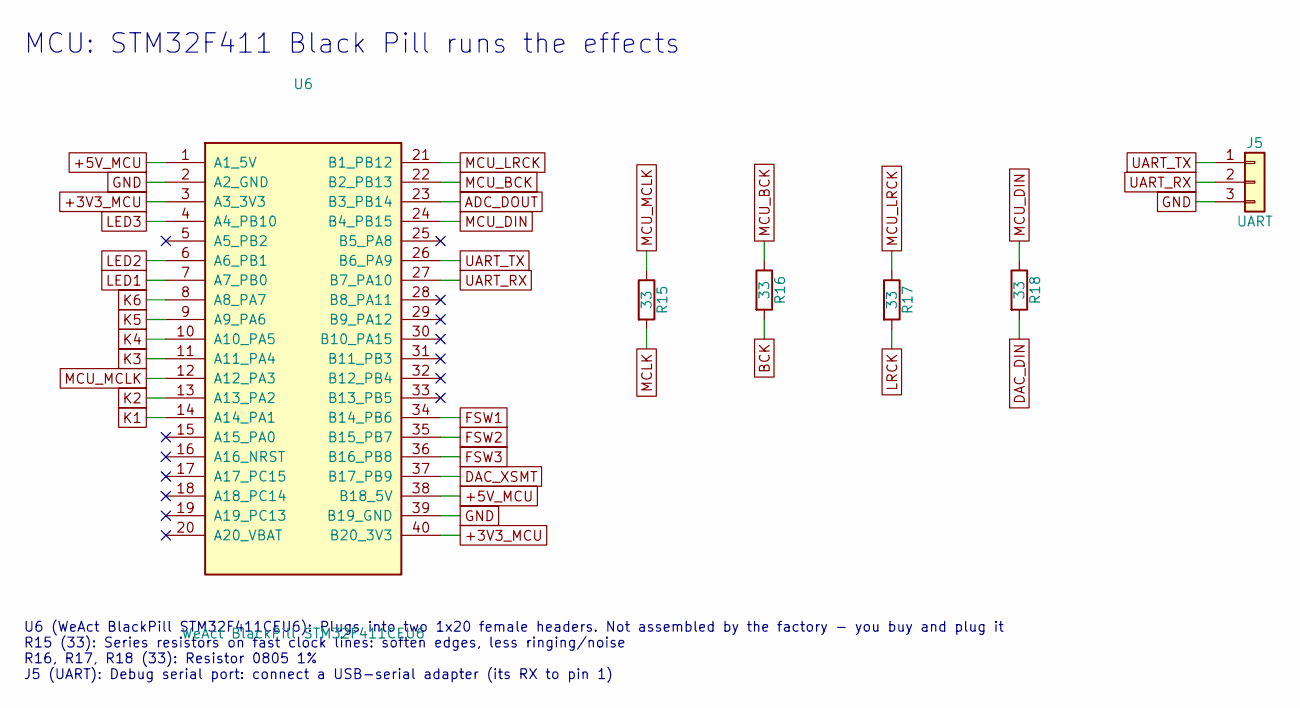
[picture p21: schematic mcu.kicad_sch, Guitar pedal - mcu]

Parts:
J5: UART; PinHeader_1x03_P2.54mm_Vertical; MPN 2.54mm header 1x3
R15, R16, R17, R18: 33; R_0805_2012Metric; MPN 0805 33 1%
U6: WeAct BlackPill STM32F411CEU6; BlackPill_Sockets; MPN WeAct BlackPill V3.0 STM32F411CEU6 (25 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

Connections:
+3V3_MCU: U6.3 (A3_3V3), U6.40 (B20_3V3); also elsewhere on the board
+5V_MCU: U6.1 (A1_5V), U6.38 (B18_5V); also elsewhere on the board
ADC_DOUT: U6.23 (B3_PB14); also elsewhere on the board
BCK: R16.2; also elsewhere on the board
DAC_DIN: R18.2; also elsewhere on the board
DAC_XSMT: U6.37 (B17_PB9); also elsewhere on the board
FSW1: U6.34 (B14_PB6); also elsewhere on the board
FSW2: U6.35 (B15_PB7); also elsewhere on the board
FSW3: U6.36 (B16_PB8); also elsewhere on the board
GND: J5.3, U6.2 (A2_GND), U6.39 (B19_GND); also elsewhere on the board
K1: U6.14 (A14_PA1); also elsewhere on the board
K2: U6.13 (A13_PA2); also elsewhere on the board
K3: U6.11 (A11_PA4); also elsewhere on the board
K4: U6.10 (A10_PA5); also elsewhere on the board
K5: U6.9 (A9_PA6); also elsewhere on the board
K6: U6.8 (A8_PA7); also elsewhere on the board
LED1: U6.7 (A7_PB0); also elsewhere on the board
LED2: U6.6 (A6_PB1); also elsewhere on the board
LED3: U6.4 (A4_PB10); also elsewhere on the board
LRCK: R17.2; also elsewhere on the board
MCLK: R15.2; also elsewhere on the board
MCU_BCK: R16.1, U6.22 (B2_PB13)
MCU_DIN: R18.1, U6.24 (B4_PB15)
MCU_LRCK: R17.1, U6.21 (B1_PB12)
MCU_MCLK: R15.1, U6.12 (A12_PA3)
UART_RX: J5.2, U6.27 (B7_PA10)
UART_TX: J5.1, U6.26 (B6_PA9)

Notes on the sheet:
MCU: STM32F411 Black Pill runs the effects
U6 (WeAct BlackPill STM32F411CEU6): Plugs into two 1x20 female headers. Not assembled by the factory - you buy and plug it R15 (33): Series resistors on fast clock lines: soften edges, less ringing/noise R16, R17, R18 (33): Resistor 0805 1% J5 (UART): Debug serial port: connect a USB-serial adapter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

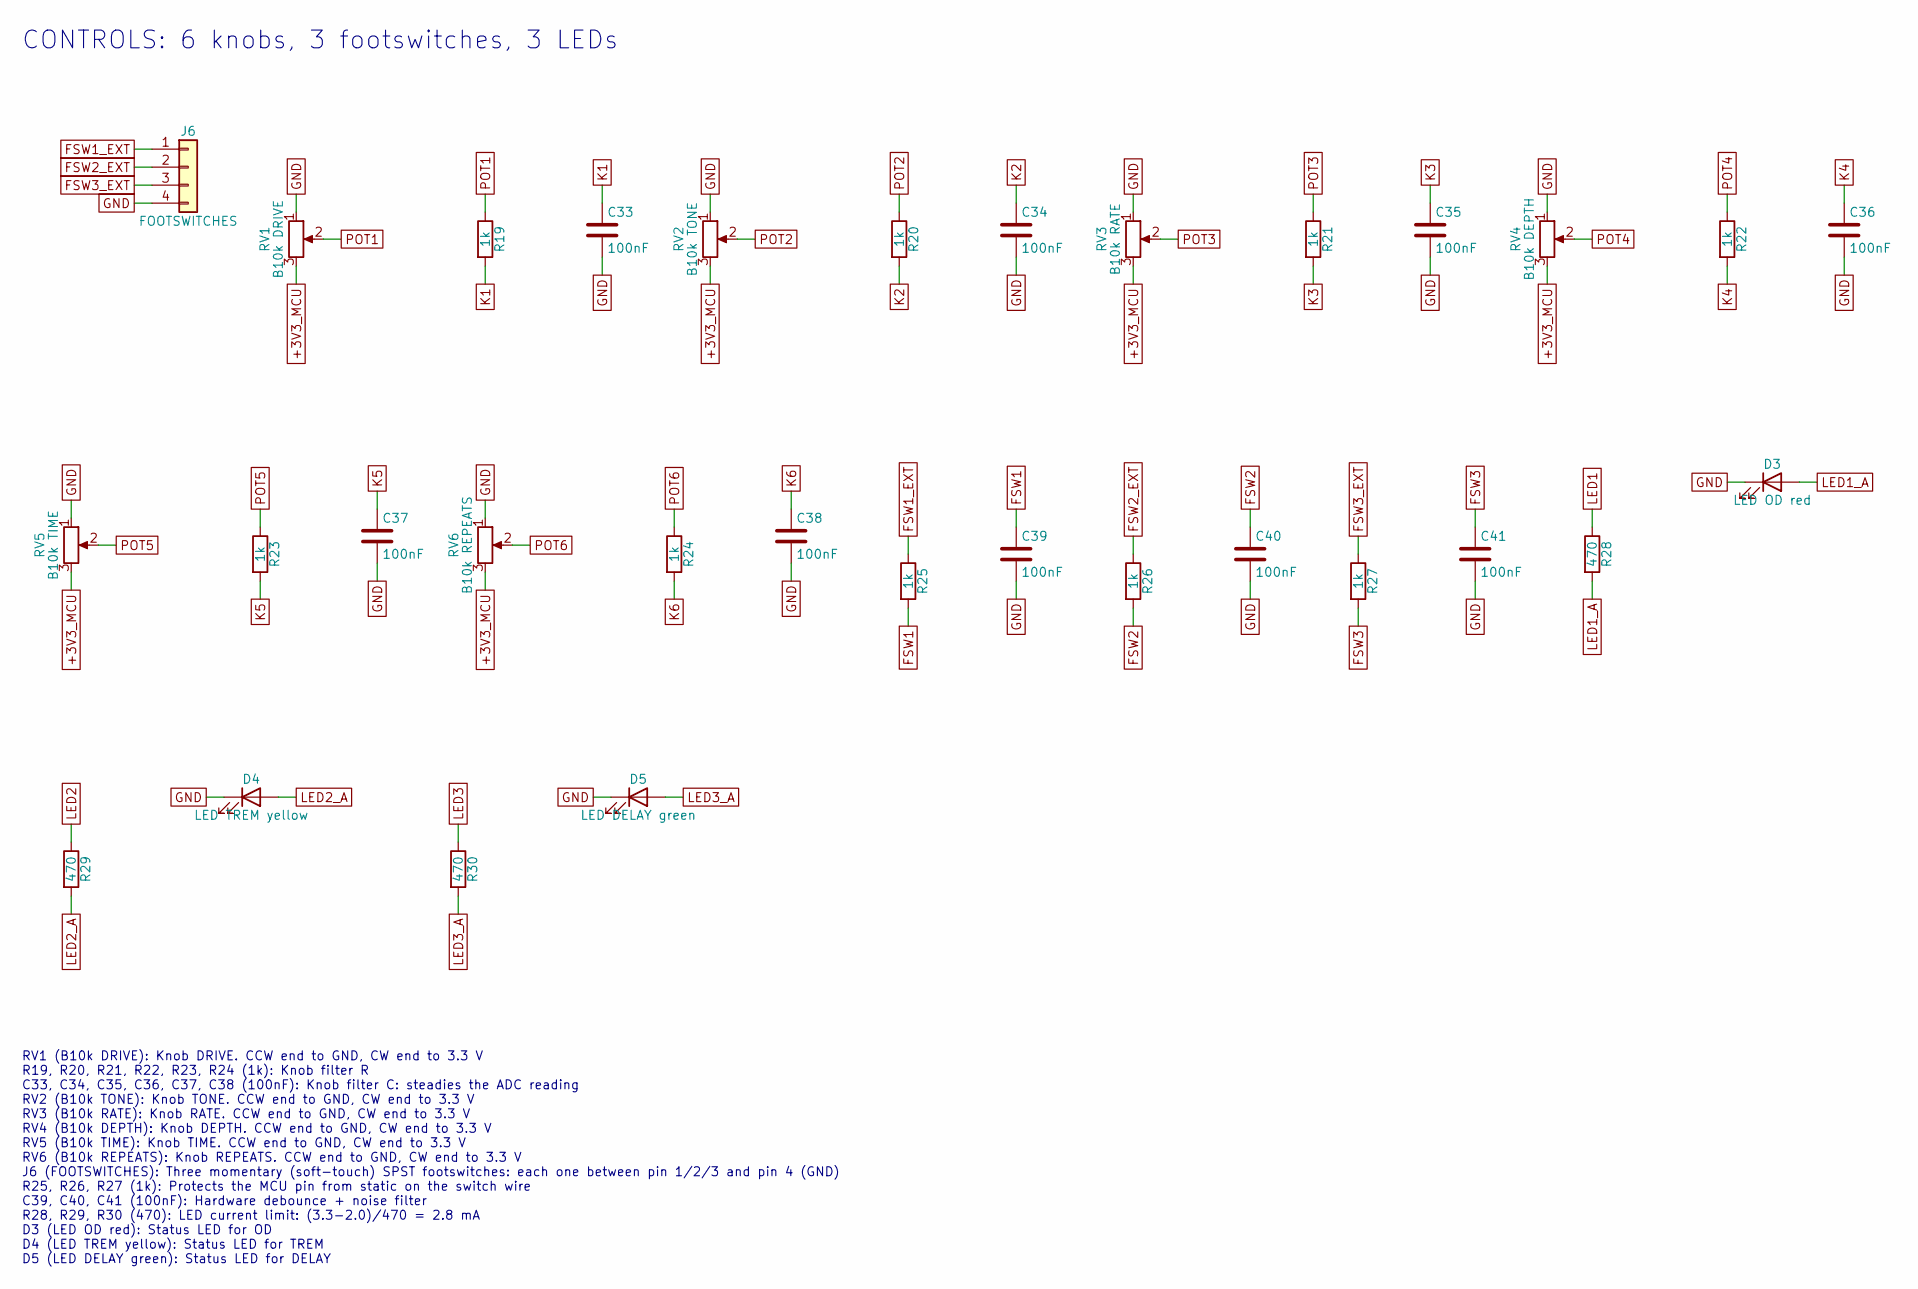
[picture p22: schematic controls.kicad_sch, Guitar pedal - controls]

Parts:
C33, C34, C35, C36, C37, C38, C39, C40, C41: 100nF; C_0805_2012Metric; MPN 0805 100nF X7R
D3: LED OD red; LED_D3.0mm; MPN 3mm red LED, diffused
D4: LED TREM yellow; LED_D3.0mm; MPN 3mm yellow LED, diffused
D5: LED DELAY green; LED_D3.0mm; MPN 3mm green LED, diffused
J6: FOOTSWITCHES; PinHeader_1x04_P2.54mm_Vertical; MPN 2.54mm header 1x4
R19, R20, R21, R22, R23, R24, R25, R26, R27: 1k; R_0805_2012Metric; MPN 0805 1k 1%
R28, R29, R30: 470; R_0805_2012Metric; MPN 0805 470 1%
RV1: B10k DRIVE; Potentiometer_Alpha_RD901F-40-00D_Single_Vertical; MPN Alpha RD901F-40 9mm B10K linear
RV2: B10k TONE; Potentiometer_Alpha_RD901F-40-00D_Single_Vertical; MPN Alpha RD901F-40 9mm B10K linear
RV3: B10k RATE; Potentiometer_Alpha_RD901F-40-00D_Single_Vertical; MPN Alpha RD901F-40 9mm B10K linear
RV4: B10k DEPTH; Potentiometer_Alpha_RD901F-40-00D_Single_Vertical; MPN Alpha RD901F-40 9mm B10K linear
RV5: B10k TIME; Potentiometer_Alpha_RD901F-40-00D_Single_Vertical; MPN Alpha RD901F-40 9mm B10K linear
RV6: B10k REPEATS; Potentiometer_Alpha_RD901F-40-00D_Single_Vertical; MPN Alpha RD901F-40 9mm B10K linear

Connections:
+3V3_MCU: RV1.3, RV2.3, RV3.3, RV4.3, RV5.3, RV6.3; also elsewhere on the board
FSW1: C39.1, R25.2; also elsewhere on the board
FSW1_EXT: J6.1, R25.1
FSW2: C40.1, R26.2; also elsewhere on the board
FSW2_EXT: J6.2, R26.1
FSW3: C41.1, R27.2; also elsewhere on the board
FSW3_EXT: J6.3, R27.1
GND: C33.2, C34.2, C35.2, C36.2, C37.2, C38.2, C39.2, C40.2, C41.2, D3.1 (K), D4.1 (K), D5.1 (K), J6.4, RV1.1, RV2.1, RV3.1, RV4.1, RV5.1, RV6.1; also elsewhere on the board
K1: C33.1, R19.2; also elsewhere on the board
K2: C34.1, R20.2; also elsewhere on the board
K3: C35.1, R21.2; also elsewhere on the board
K4: C36.1, R22.2; also elsewhere on the board
K5: C37.1, R23.2; also elsewhere on the board
K6: C38.1, R24.2; also elsewhere on the board
LED1: R28.1; also elsewhere on the board
LED1_A: D3.2 (A), R28.2
LED2: R29.1; also elsewhere on the board
LED2_A: D4.2 (A), R29.2
LED3: R30.1; also elsewhere on the board
LED3_A: D5.2 (A), R30.2
POT1: R19.1, RV1.2
POT2: R20.1, RV2.2
POT3: R21.1, RV3.2
POT4: R22.1, RV4.2
POT5: R23.1, RV5.2
POT6: R24.1, RV6.2

Notes on the sheet:
CONTROLS: 6 knobs, 3 footswitches, 3 LEDs
RV1 (B10k DRIVE): Knob DRIVE. CCW end to GND, CW end to 3.3 V R19, R20, R21, R22, R23, R24 (1k): Knob filter R C33, C34, C35, C36, C37, C38 (100nF): Knob filter C: steadies the ADC reading RV2 (B10k TONE): Knob TONE. CCW end to GND, CW end to 3.3 V RV3 (B10k RATE): Knob RATE. CCW end to GND, CW end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

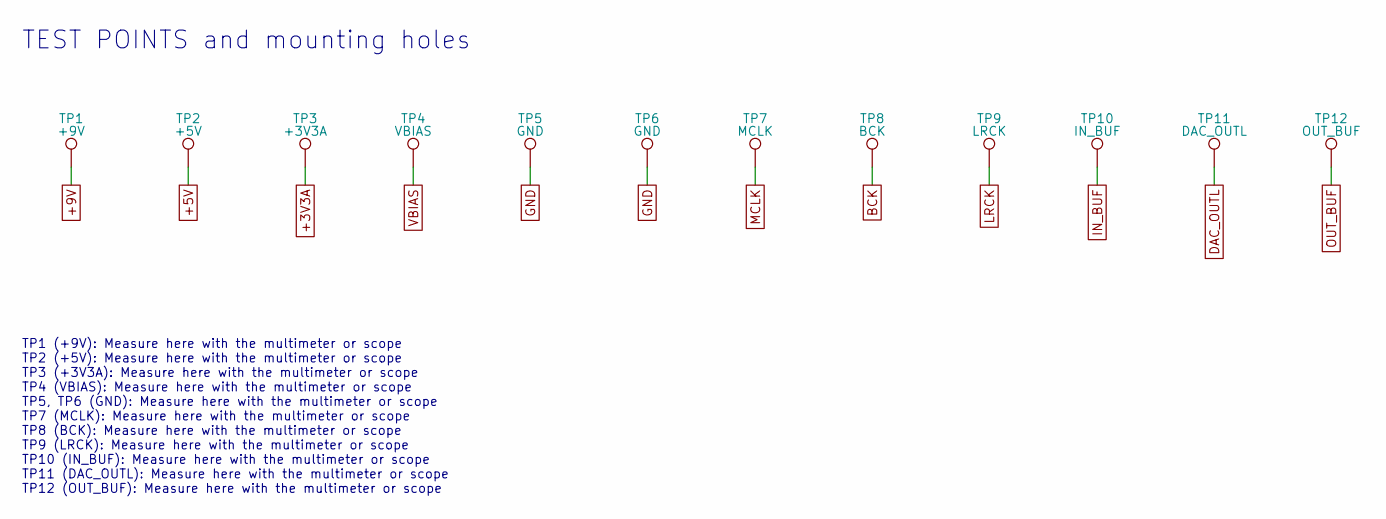
[picture p23: schematic test.kicad_sch, Guitar pedal - test]

Parts:
TP1: +9V; TestPoint_THTPad_D2.0mm_Drill1.0mm; MPN (no part - bare pad, probe here)
TP2: +5V; TestPoint_THTPad_D2.0mm_Drill1.0mm; MPN (no part - bare pad, probe here)
TP3: +3V3A; TestPoint_THTPad_D2.0mm_Drill1.0mm; MPN (no part - bare pad, probe here)
TP4: VBIAS; TestPoint_THTPad_D2.0mm_Drill1.0mm; MPN (no part - bare pad, probe here)
TP5, TP6: GND; TestPoint_THTPad_D2.0mm_Drill1.0mm; MPN (no part - bare pad, probe here)
TP7: MCLK; TestPoint_THTPad_D2.0mm_Drill1.0mm; MPN (no part - bare pad, probe here)
TP8: BCK; TestPoint_THTPad_D2.0mm_Drill1.0mm; MPN (no part - bare pad, probe here)
TP9: LRCK; TestPoint_THTPad_D2.0mm_Drill1.0mm; MPN (no part - bare pad, probe here)
TP10: IN_BUF; TestPoint_THTPad_D2.0mm_Drill1.0mm; MPN (no part - bare pad, probe here)
TP11: DAC_OUTL; TestPoint_THTPad_D2.0mm_Drill1.0mm; MPN (no part - bare pad, probe here)
TP12: OUT_BUF; TestPoint_THTPad_D2.0mm_Drill1.0mm; MPN (no part - bare pad, probe here)

Connections:
+3V3A: TP3.1; also elsewhere on the board
+5V: TP2.1; also elsewhere on the board
+9V: TP1.1; also elsewhere on the board
BCK: TP8.1; also elsewhere on the board
DAC_OUTL: TP11.1; also elsewhere on the board
GND: TP5.1, TP6.1; also elsewhere on the board
IN_BUF: TP10.1; also elsewhere on the board
LRCK: TP9.1; also elsewhere on the board
MCLK: TP7.1; also elsewhere on the board
OUT_BUF: TP12.1; also elsewhere on the board
VBIAS: TP4.1; also elsewhere on the board

Notes on the sheet:
TEST POINTS and mounting holes
TP1 (+9V): Measure here with the multimeter or scope TP2 (+5V): Measure here with the multimeter or scope TP3 (+3V3A): Measure here with the multimeter or scope TP4 (VBIAS): Measure here with the multimeter or scope TP5, TP6 (GND): Measure here with the multimeter or scope TP7 (MCLK): Measure here 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

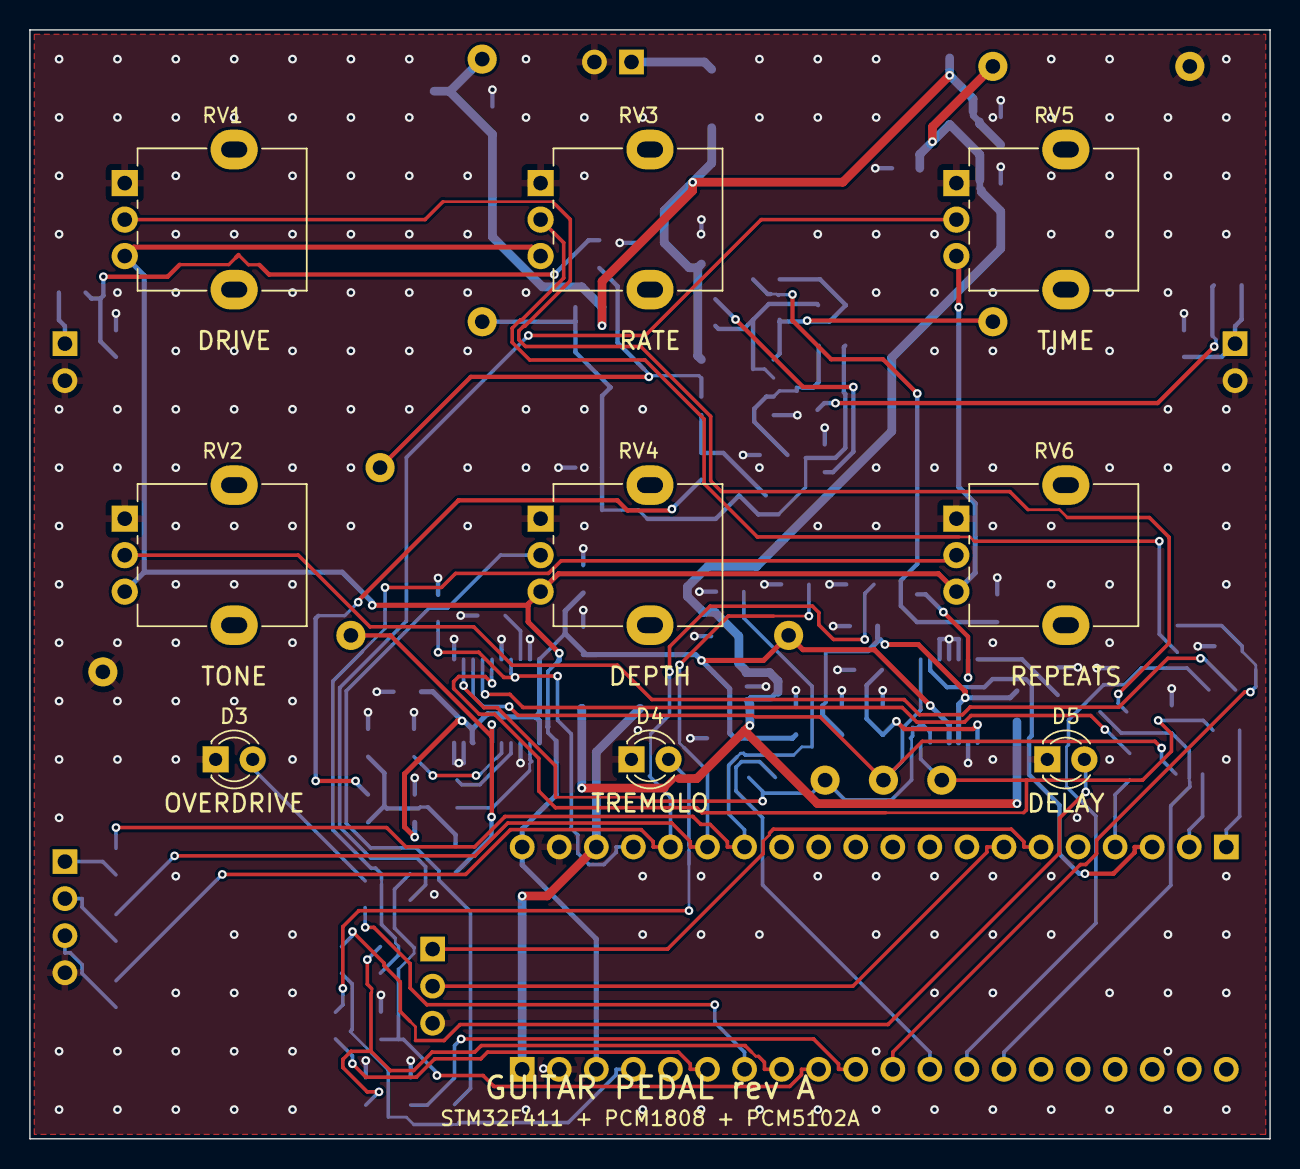
[picture p24: board pedal.kicad_pcb from above]

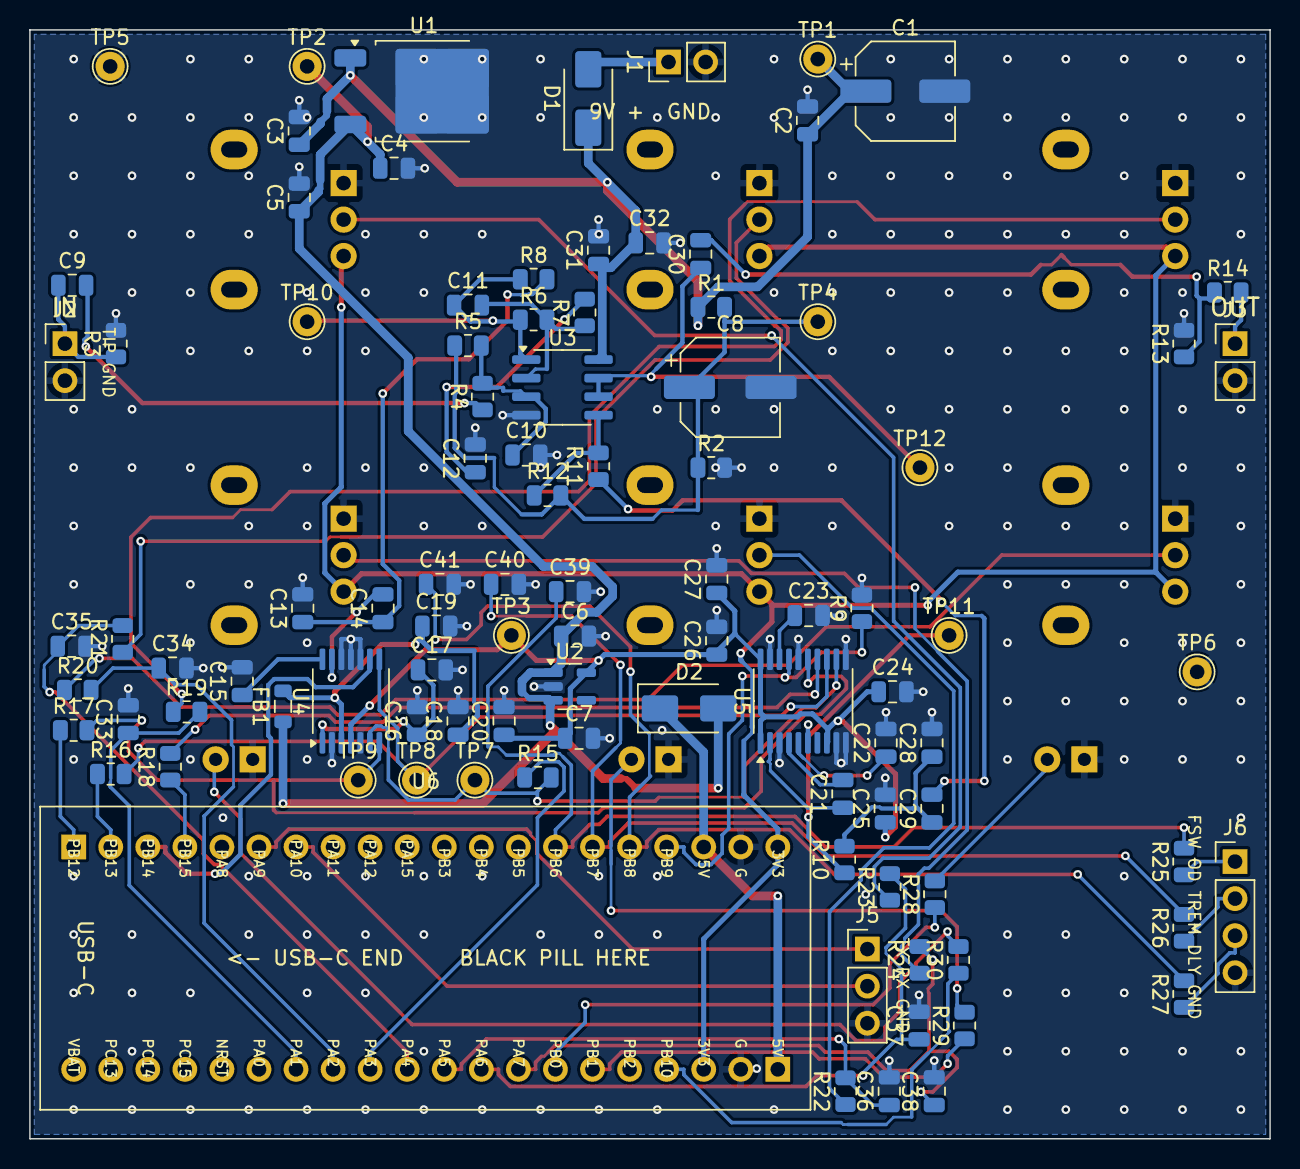
[picture p25: board pedal.kicad_pcb from below]

Board: 2 copper layers, 85.0 x 76.0 mm, 106 parts (97 on the bottom side), 66 nets.
